Fijee-Project/utCS/doc/design_draft/src/main.tex

\documentclass[reprint]{revtex4-1}
\usepackage{graphicx}
\usepackage{amsmath}
\usepackage{epstopdf}

\begin{document}
\title{tDCS Current Driver- Design Draft}
\date{12-17-2013 Revision 1}
\author{Andrey Shmakov }

\begin{abstract}
An Engineering design draft for the tDCS current driver developed for Gazzaley lab at the University of California, San Francisco. This design draft discusses the theory of operation and the technical implementation of a computer programmable precise current source used for current injection to for rapid impedance measurements of the skull and brain to facilitate precise EEG readings
\end{abstract}
\maketitle

\input{text/goverview}

\input{text/design}

\end{document}
