Fijee-Project/utCS/doc/design_draft/src/text/design.tex

% !TEX root = ../main.tex

%TODO 1-31, everything on this page.

\section{Circuit Design}

The following sections describe the specific implementation details of the tDCS current driver. The device can split into three components. The current driver consisting of a digitally controlled voltage source and an analog voltage-to-current converter with digitally selectable gain, A multiplexer/demultiplexer module that allows coupling to a variety of different tDCS systems, and a microcontroller module that acts interfaces with all the digital devices. 

\subsection{Current Driver}
%Write a general introduction to this section
\subsubsection{Source signal generator}
% talk about the signal source generator, include a detailed connection diagram

\subsubsection{Voltage to current conversion}
%talk about the instrumentation amplifier conversion module and theory of operation, include detailed diagram

\subsubsection{Gain control}

\subsection{Multiplexer/Demultiplexer}

\subsection{Microcontroller/PC interfacing}
