Fijee-Project/utCS/doc/design_docs/BRD1ENG_SUM/text/sections/pcb/pcb.tex

\section{PCB Design}

\subsection{Layout}
