Fijee-Project/utCS/doc/design_docs/BRD1ENG_SUM/text/sections/abstract/abstract.tex

The TDCS current driver design has two component boards (see doc-
ument: TDCS Design Summary). This document describes the main
board (BRD1) of the TDCS current driver. BRD1 houses a signal gen-
erator and current driver , as well as the first bank of switches for probe
multiplexing.
