Fijee-Project/utCS/doc/design_docs/BRD1ENG_SUM/text/sections/appendices/appendixA.tex

\section{Circuit Diagrams}

\section{PCB Images}

\section{Bill Of Materials}
