Fijee-Project/utCS/doc/design_docs/BRD1ENG_SUM/text/sections/overview/overview.tex

\section*{Overview}
This document provides a comprehensive engineering summary of the TDCS device mainboard (Engineering designation BRD1). This document follows the following general outline: Schematic design, component selection, PC board layout, manufacturing, and assembly. The appendices contain full page technical drawings of the schematic, pcb layout, and bill of materials, including pcb component dimensions and pcb footprint specifications.
