Fijee-Project/utCS/doc/notes/tdcs_keepnote_notebook/main board/pcb/connectors/screenshot from 2014-03-11 171706.png

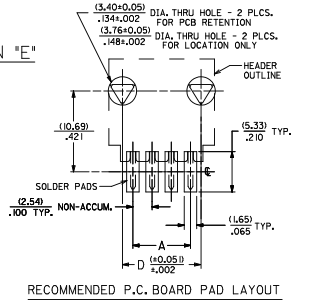
doc/notes/tdcs_keepnote_notebook/main board/pcb/connectors/screenshot from 2014-03-11 171706.png
