Fijee-Project/utCS/doc/notes/tdcs_keepnote_notebook/main board/pcb/connectors/screenshot from 2014-03-14 152904.png

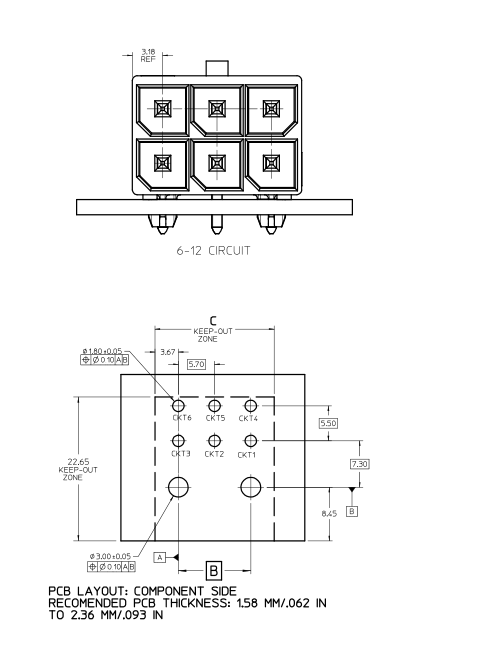
doc/notes/tdcs_keepnote_notebook/main board/pcb/connectors/screenshot from 2014-03-14 152904.png
