Fijee-Project/utCS/doc/notes/tdcs_keepnote_notebook/main board/pcb/connectors/screenshot from 2014-03-15 175426.png

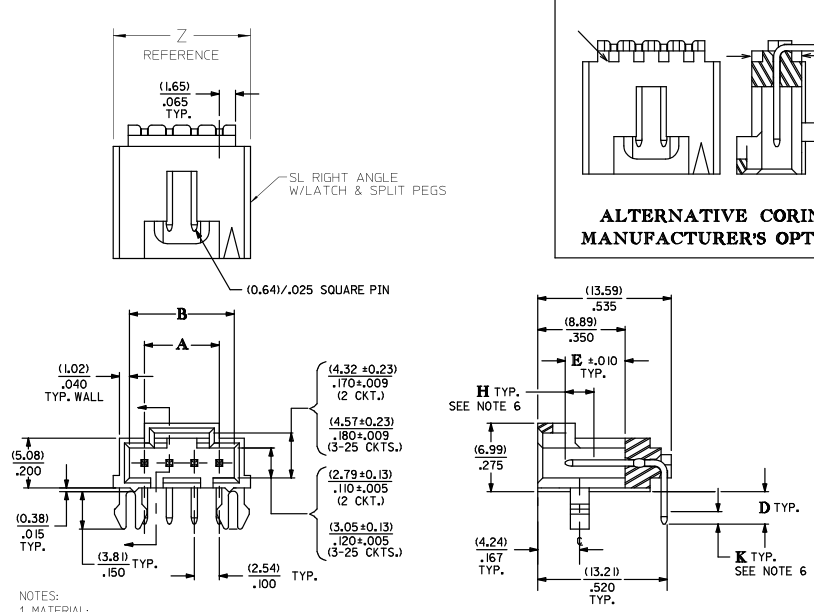
doc/notes/tdcs_keepnote_notebook/main board/pcb/connectors/screenshot from 2014-03-15 175426.png
