Fijee-Project/utCS/doc/notes/tdcs_keepnote_notebook/main board/pcb/dds stage/screenshot from 2014-03-10 201614.png

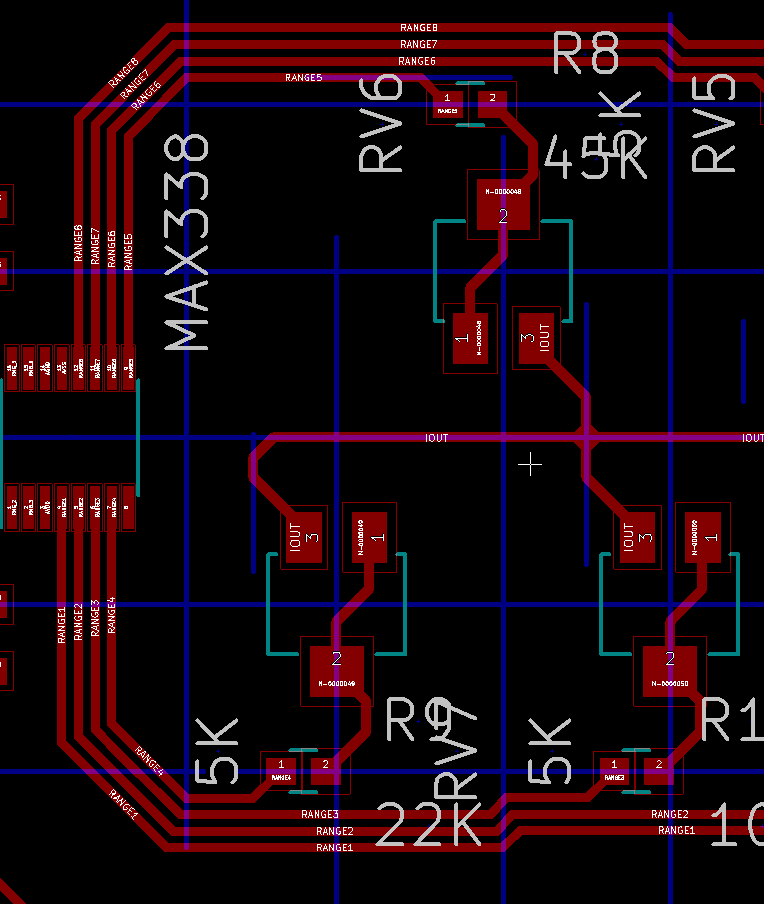
doc/notes/tdcs_keepnote_notebook/main board/pcb/dds stage/screenshot from 2014-03-10 201614.png
