Fijee-Project/utCS/doc/notes/tdcs_keepnote_notebook/main board/schematic/dds stage/screenshot from 2014-03-05 201427.png

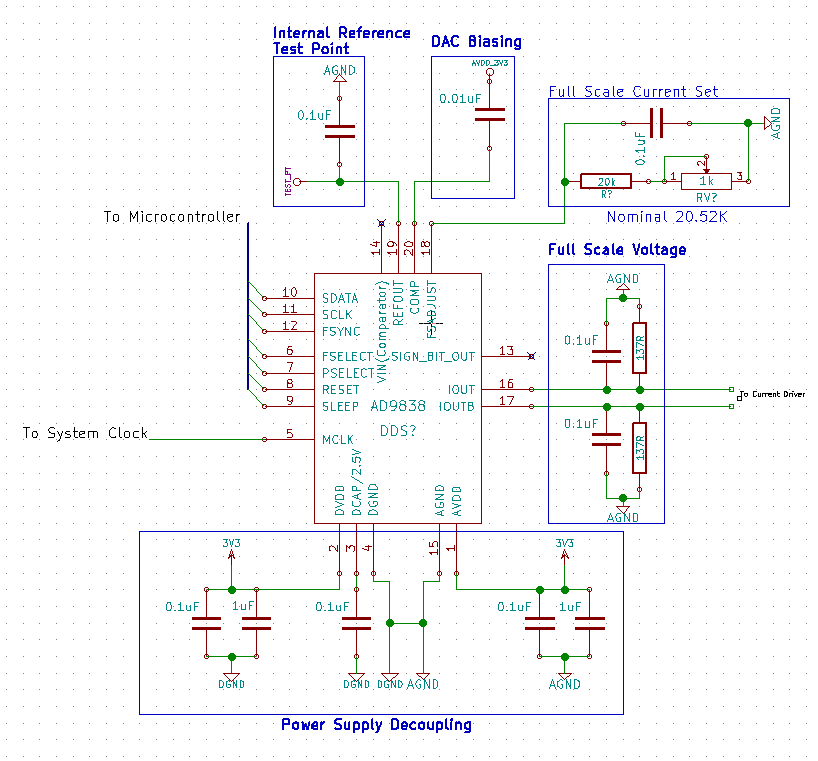
doc/notes/tdcs_keepnote_notebook/main board/schematic/dds stage/screenshot from 2014-03-05 201427.png
