Fijee-Project/utCS/doc/notes/tdcs_keepnote_notebook/mux daughterboard/pcb/connectors/screenshot from 2014-03-14 194821.png

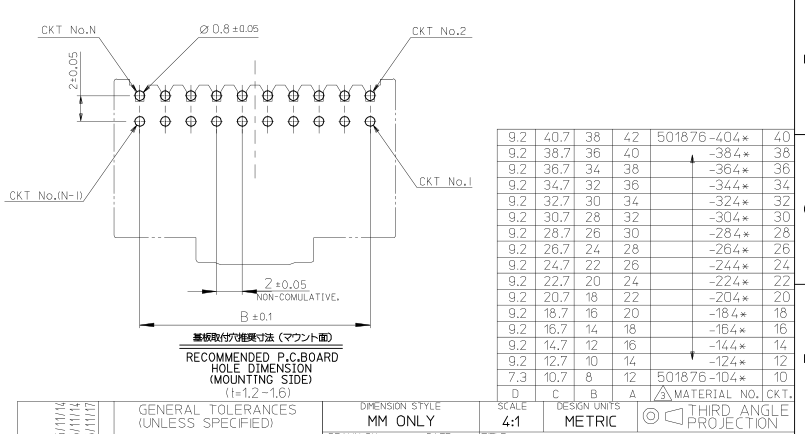
doc/notes/tdcs_keepnote_notebook/mux daughterboard/pcb/connectors/screenshot from 2014-03-14 194821.png
