Fijee-Project/utCS/doc/notes/tdcs_keepnote_notebook/mux daughterboard/pcb/physical layout/brd.png

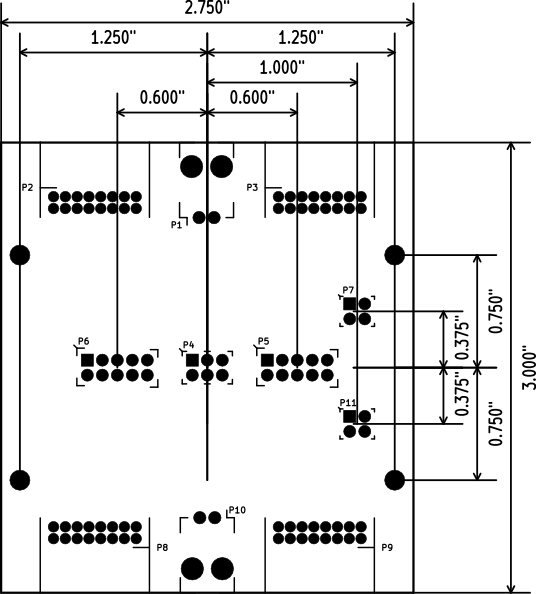
doc/notes/tdcs_keepnote_notebook/mux daughterboard/pcb/physical layout/brd.png
