Fijee-Project/utCS/doc/notes/tdcs_keepnote_notebook/package notes/ad5292/screenshot from 2014-02-27 185433.png

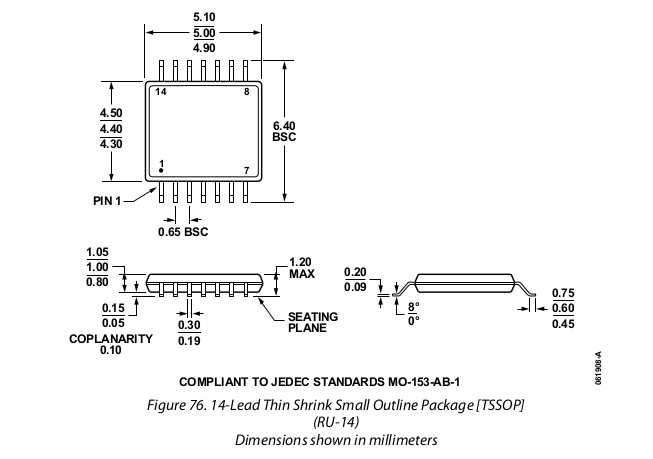
doc/notes/tdcs_keepnote_notebook/package notes/ad5292/screenshot from 2014-02-27 185433.png
