Fijee-Project/utCS/doc/notes/tdcs_keepnote_notebook/package notes/ad8221/screenshot from 2014-02-28 171705.png

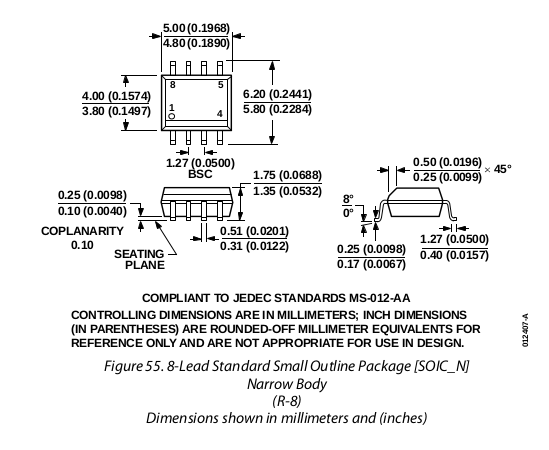
doc/notes/tdcs_keepnote_notebook/package notes/ad8221/screenshot from 2014-02-28 171705.png
