Fijee-Project/utCS/doc/notes/tdcs_keepnote_notebook/package notes/ad9838/screenshot from 2014-02-27 181038.png

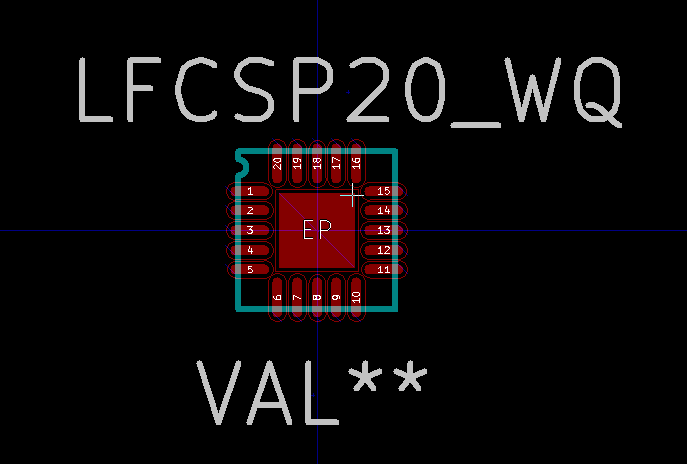
doc/notes/tdcs_keepnote_notebook/package notes/ad9838/screenshot from 2014-02-27 181038.png
