Fijee-Project/utCS/doc/notes/tdcs_keepnote_notebook/package notes/adg732/screenshot from 2014-03-14 213722.png

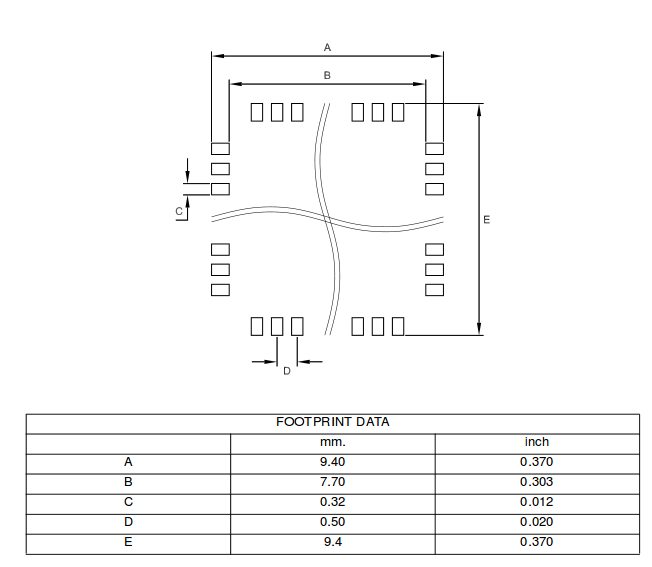
doc/notes/tdcs_keepnote_notebook/package notes/adg732/screenshot from 2014-03-14 213722.png
