Fijee-Project/utCS/doc/notes/tdcs_keepnote_notebook/package notes/chip resistors and chip capactiros/screenshot from 2014-02-28 184616.png

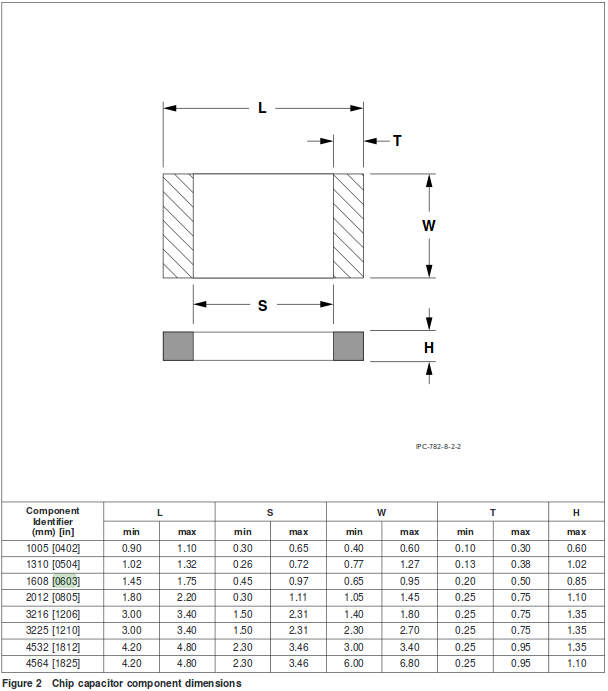
doc/notes/tdcs_keepnote_notebook/package notes/chip resistors and chip capactiros/screenshot from 2014-02-28 184616.png
