Fijee-Project/utCS/doc/notes/tdcs_keepnote_notebook/package notes/ecx-53b crystal/screenshot from 2014-02-28 180053.png

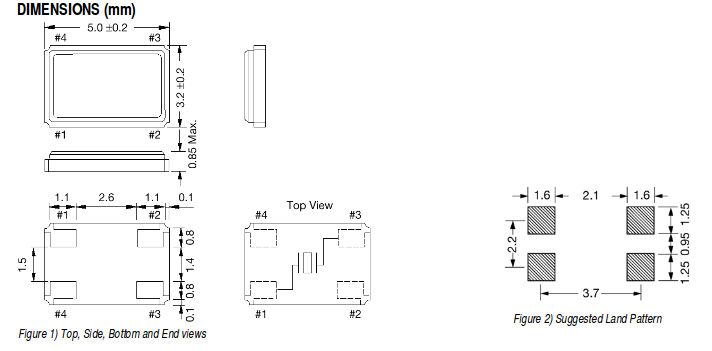
doc/notes/tdcs_keepnote_notebook/package notes/ecx-53b crystal/screenshot from 2014-02-28 180053.png
