Fijee-Project/utCS/doc/notes/tdcs_keepnote_notebook/package notes/max338-339/screenshot from 2014-02-28 155805.png

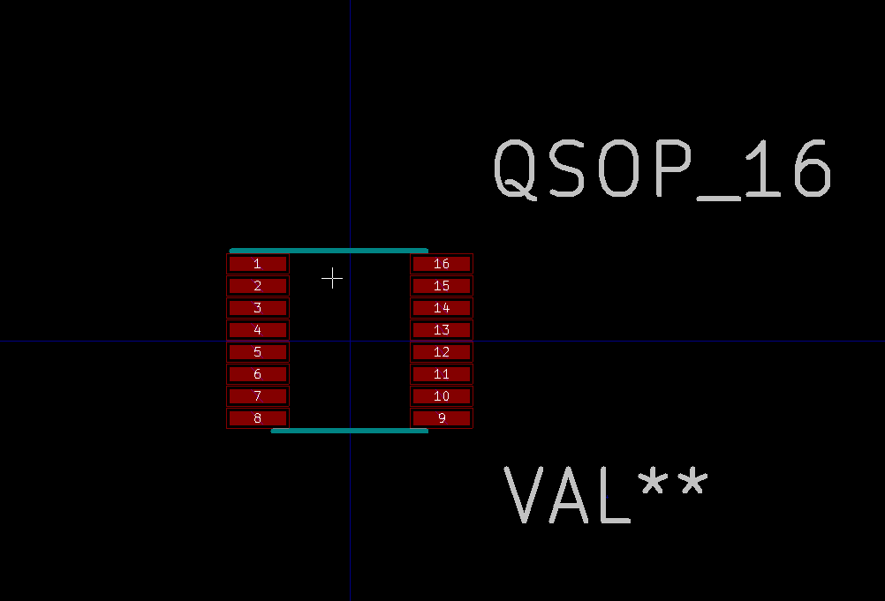
doc/notes/tdcs_keepnote_notebook/package notes/max338-339/screenshot from 2014-02-28 155805.png
