Fijee-Project/utCS/doc/notes/tdcs_keepnote_notebook/package notes/max3002/screenshot from 2014-02-28 190120.png

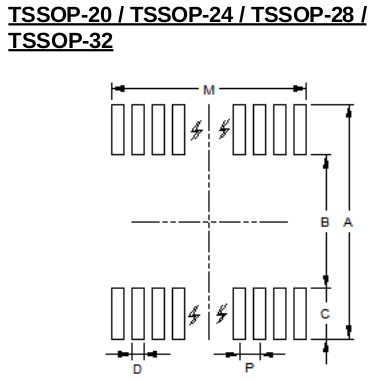
doc/notes/tdcs_keepnote_notebook/package notes/max3002/screenshot from 2014-02-28 190120.png
