Fijee-Project/utCS/doc/notes/tdcs_keepnote_notebook/package notes/si5351a/screenshot from 2014-02-28 163953.png

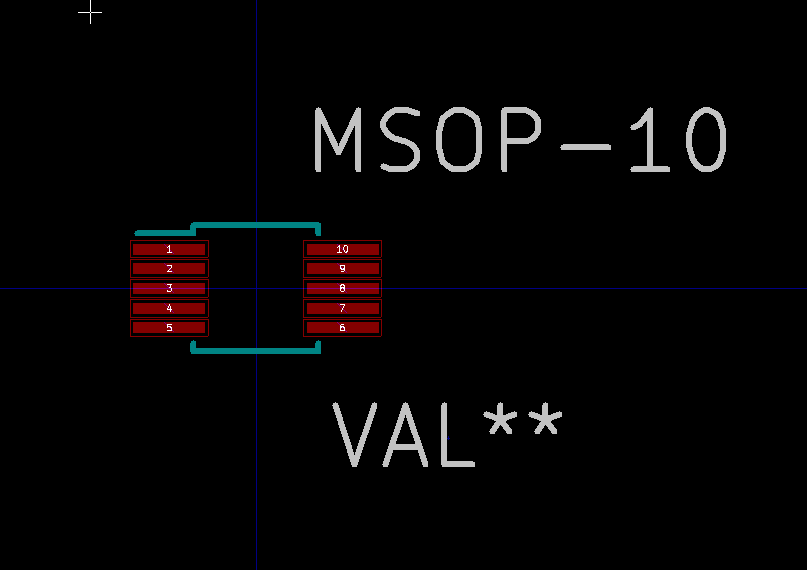
doc/notes/tdcs_keepnote_notebook/package notes/si5351a/screenshot from 2014-02-28 163953.png
