Fijee-Project/utCS/doc/notes/tdcs_keepnote_notebook/package notes/smd-trimpots (bourne 3224)/screenshot from 2014-02-28 174825.png

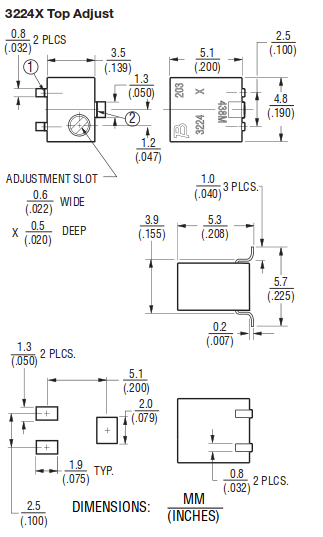
doc/notes/tdcs_keepnote_notebook/package notes/smd-trimpots (bourne 3224)/screenshot from 2014-02-28 174825.png
