Fijee-Project/utCS/doc/notes/tdcs_keepnote_notebook/mux daughterboard/schematic/components/screenshot from 2014-03-15 164229.png

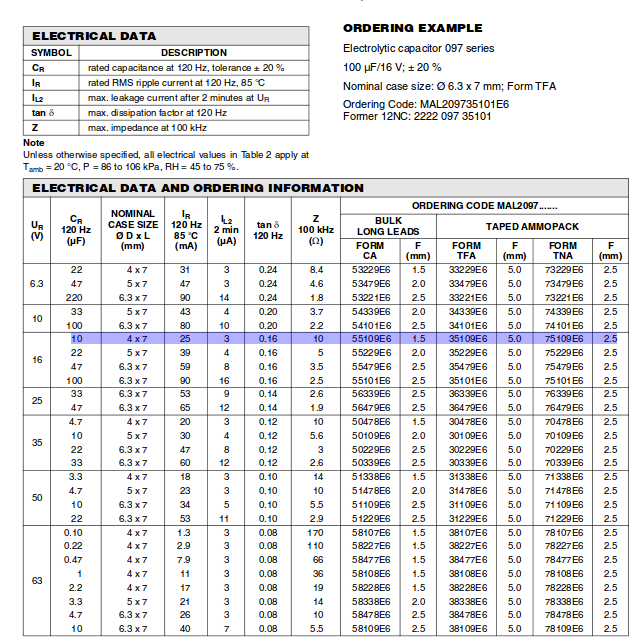
doc/notes/tdcs_keepnote_notebook/mux daughterboard/schematic/components/screenshot from 2014-03-15 164229.png
