Fijee-Project/utCS/doc/notes/tdcs_keepnote_notebook/current todo/page.html

Current TODO list

DaughterBoard:
production:
Verify all ic footprints
Create gerber and drill file
check gerber and drill file
send off to seeedstudio

design:
migrate all component symbols, modules, and footprints to custom libraries for each project.

MainBoard:

design:
Verify/create all module footprints (Done for mainboard 2/28)
Rough Design of module layoutv (Doneish)
Choose board connectors for interfacing (make footprints) (Done for mainboard 3/14)
Desing/route/gerber (Partial as of 3/14)
FIX SILKSCREEN FOR COMPONENTS, too messy.
