Fijee-Project/utCS/doc/design_draft/src/images/generaldiagram/current-eps-converted-to.pdf

# Current ReturnParallel

# Microcontroller

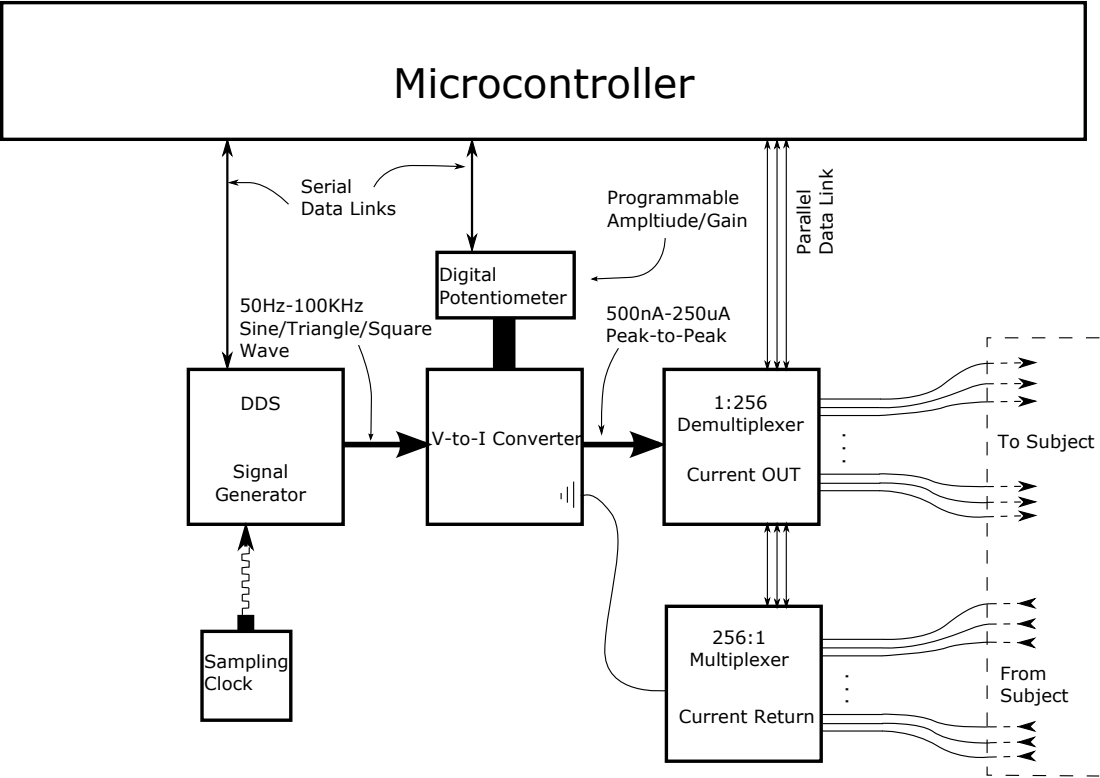
[picture p45: page 1]
Digital Potentiometer; Programmable Ampltiude/Gain; V-to-I Converter; DDS; Signal Generator; Serial Data Links; Sampling Clock; 1:256 Demultiplexer; Current OUT; 256:1 Multiplexer; Data Link; To Subject; From Subject; 50Hz-100KHz Sine/Triangle/Square Wave

Peak-to-Peak
