Fijee-Project/utCS/hw/main_board/kicad_project/tDCS_driver.pdf

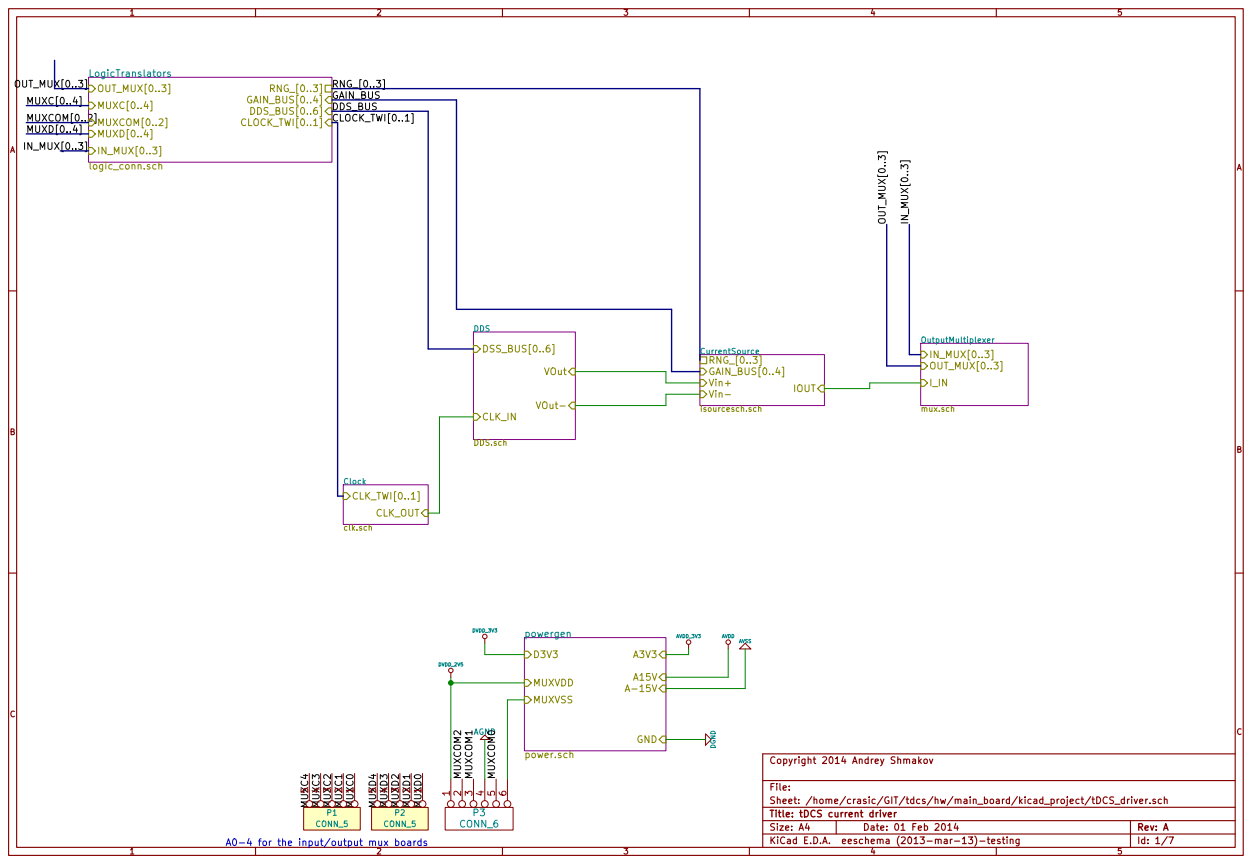
[picture p46: page 1]

isourcesch.sch Vin+ Vin- RNG_[0..3]
GAIN_BUS[0..4]

KiCad E.D.A. eeschema (2013-mar-13)-testing Date: 01 Feb 2014 DGND

Sheet: /home/crasic/GIT/tdcs/hw/main_board/kicad_project/tDCS_driver.sch File: Title: tDCS current driver

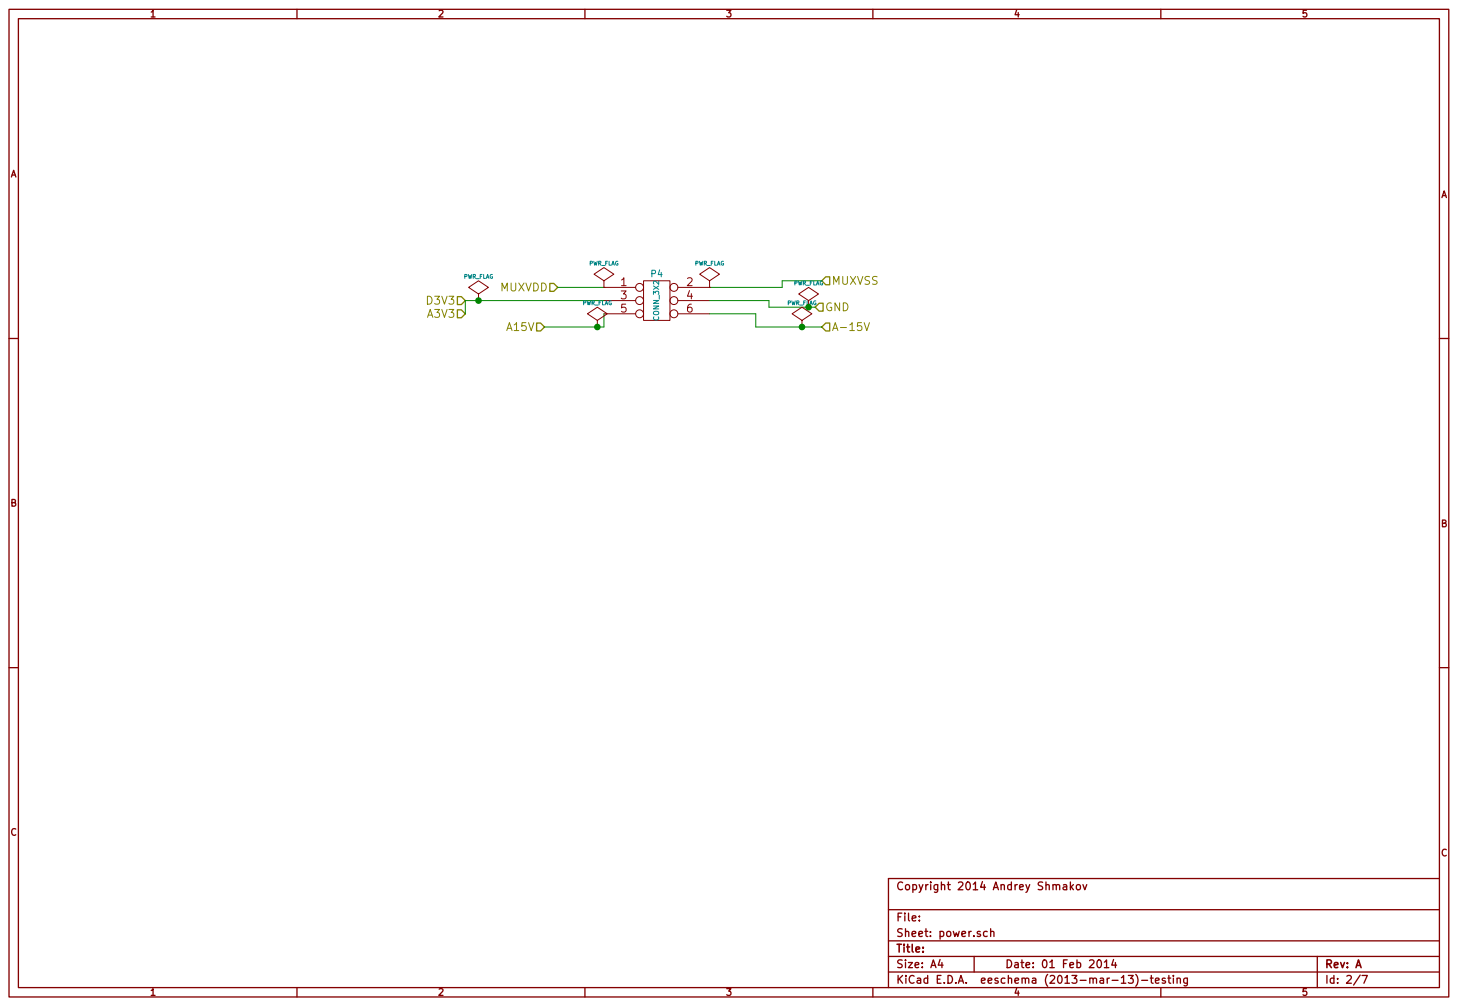
[picture p47: page 2]

Sheet: power.sch File: Title:

KiCad E.D.A. eeschema (2013-mar-13)-testing Date: 01 Feb 2014

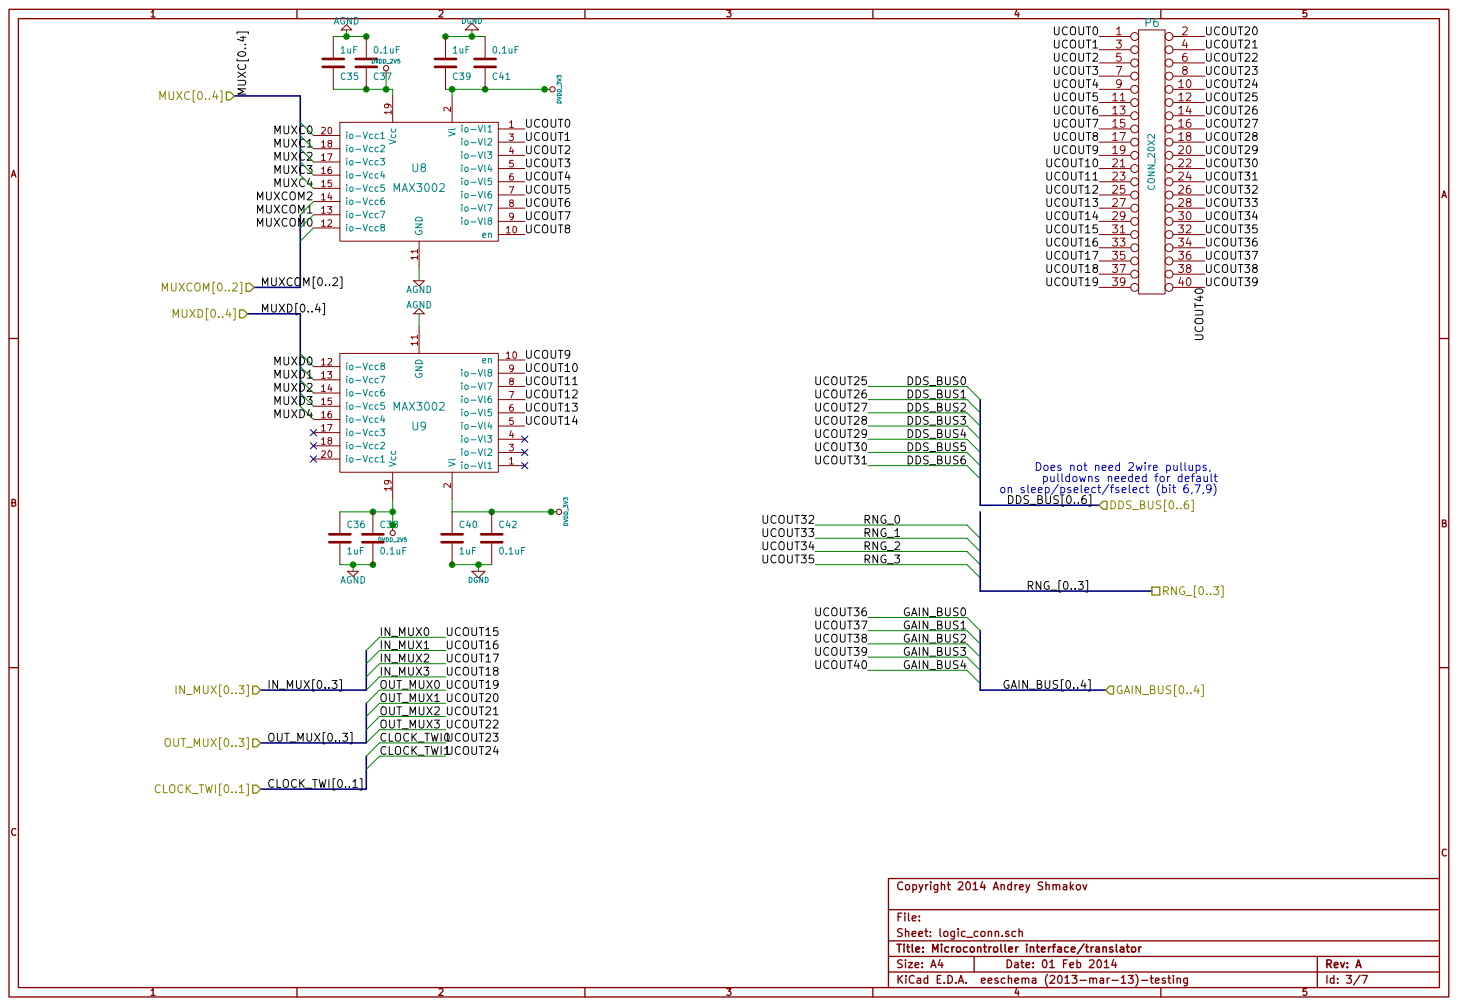
[picture p48: page 3]

Does not need 2wire pullups,
pulldowns needed for default
on sleep/pselect/fselect (bit 6,7,9)
DDS_BUS[0..6]

Sheet: logic_conn.sch File: Title: Microcontroller interface/translator

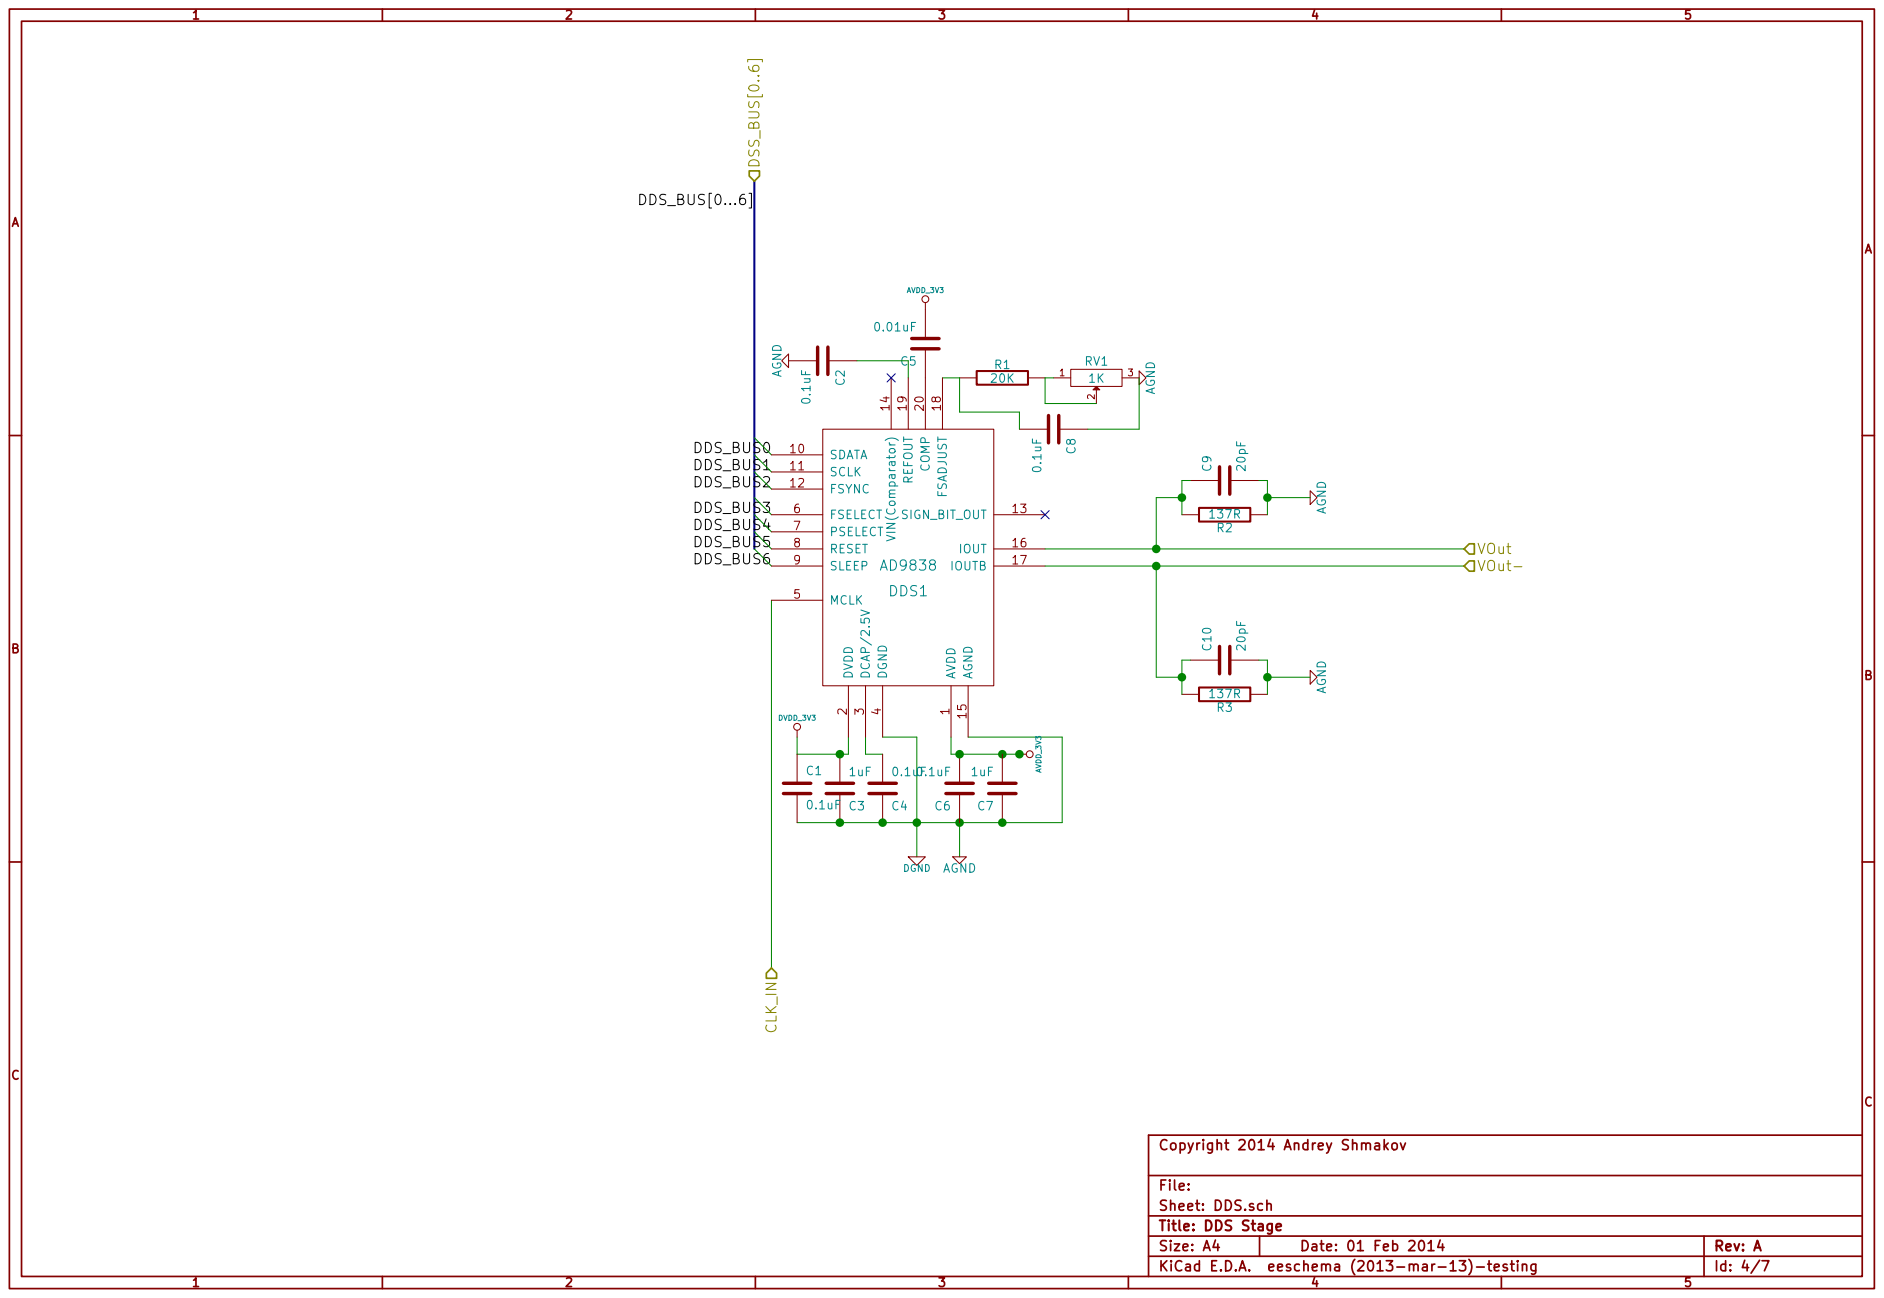
[picture p49: page 4]

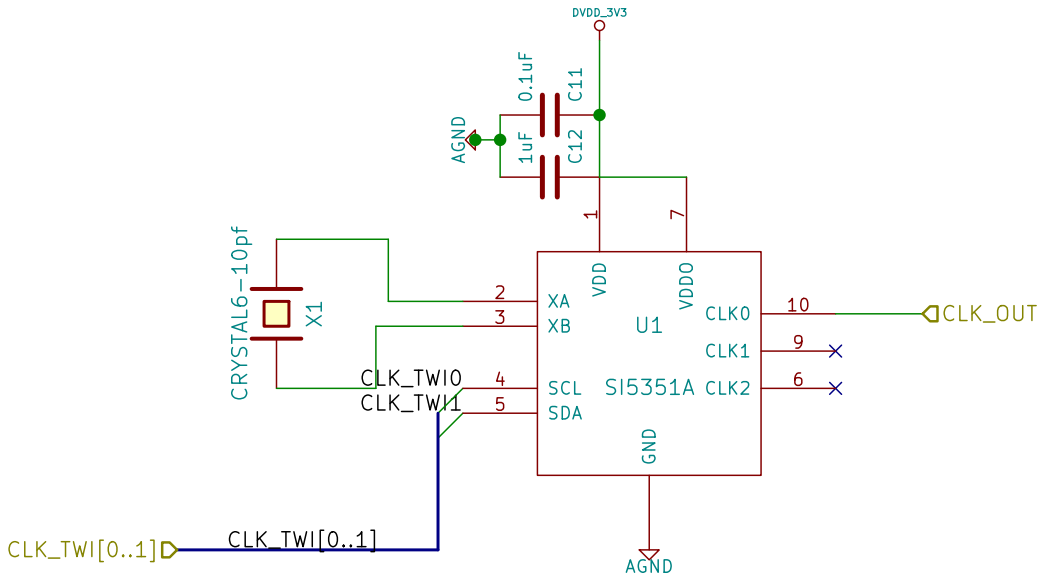
[picture p50: page 5]

1 XA 2 XB 3 SCL 4 SDA 5 CLK2 6 VDDO

C Copyright 2014 Andrey Shmakov Sheet: clk.sch File: Title: Clock

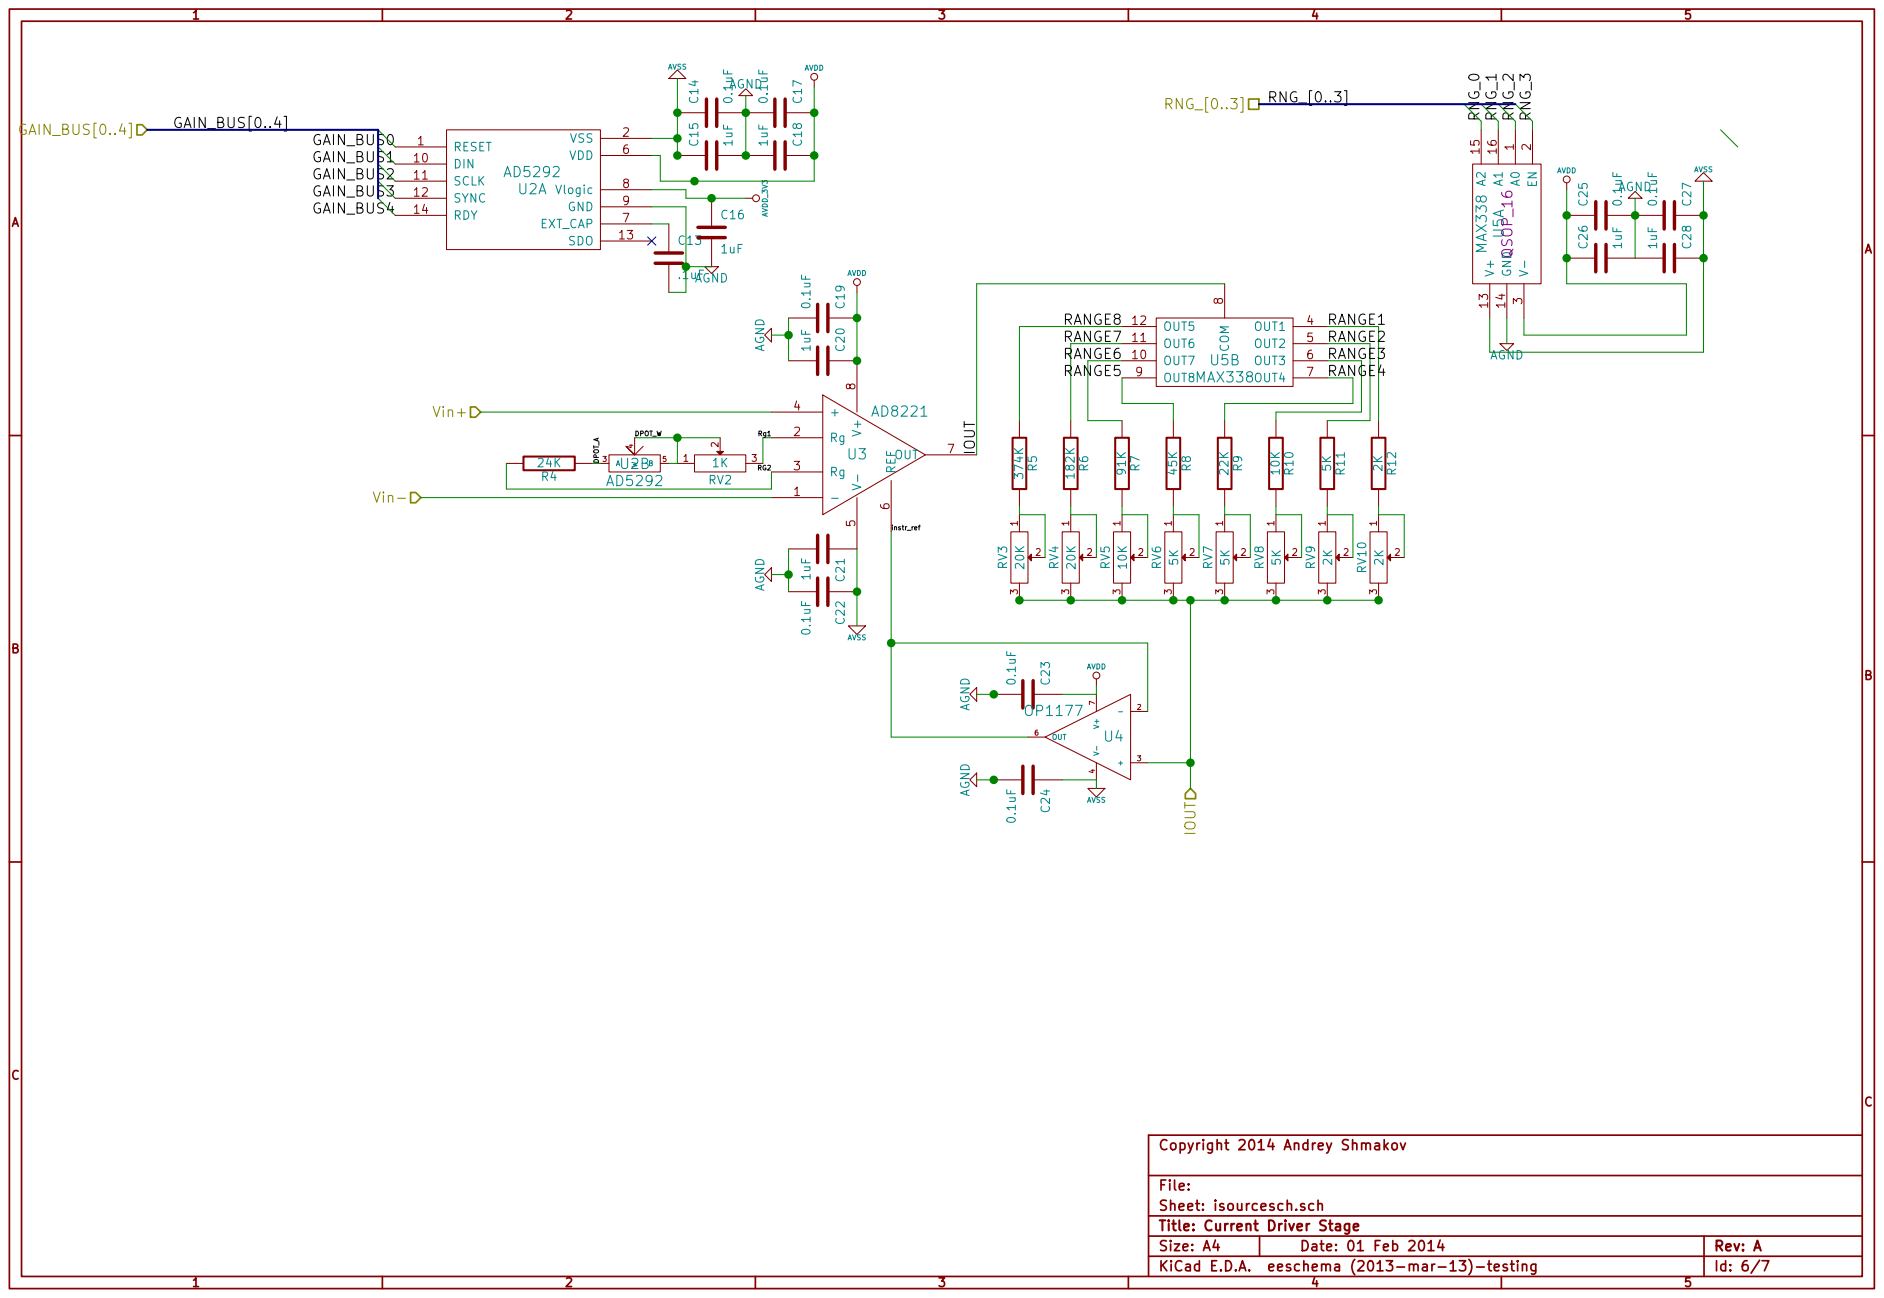
[picture p51: page 6]

C Copyright 2014 Andrey Shmakov Sheet: isourcesch.sch File: Title: Current Driver Stage

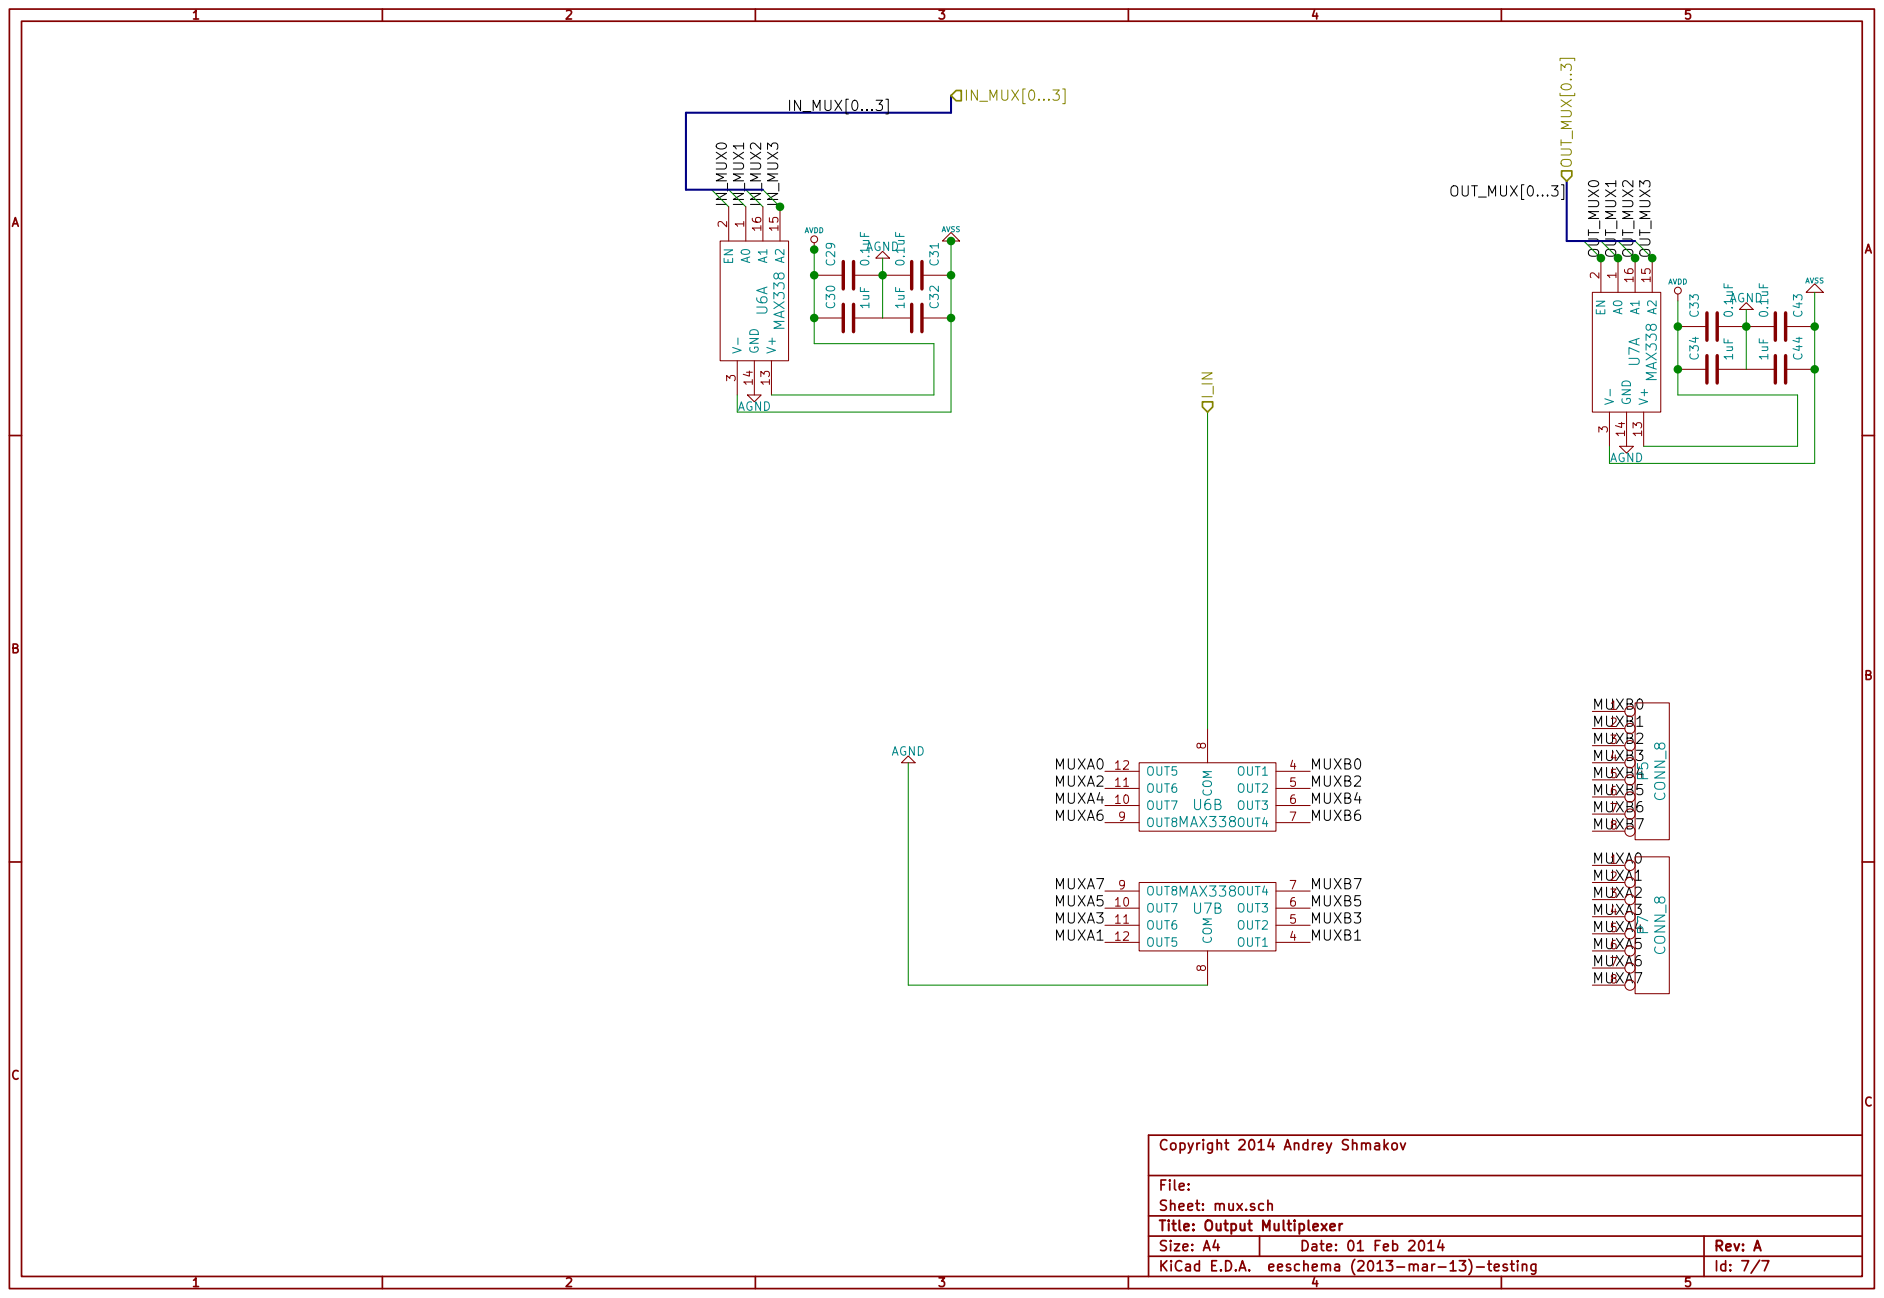
[picture p52: page 7]

KiCad E.D.A. eeschema (2013-mar-13)-testing Date: 01 Feb 2014 MUXB7 MUXB6 MUXB5 MUXB4 MUXB3 MUXB2 MUXB1 MUXB0 MUXA7 MUXA6 MUXA5 MUXA4 MUXA3 MUXA2 MUXA1 MUXA0
