Fijee-Project/utCS/doc/design_draft/src/images/brdlayout/board_layout-full.pdf

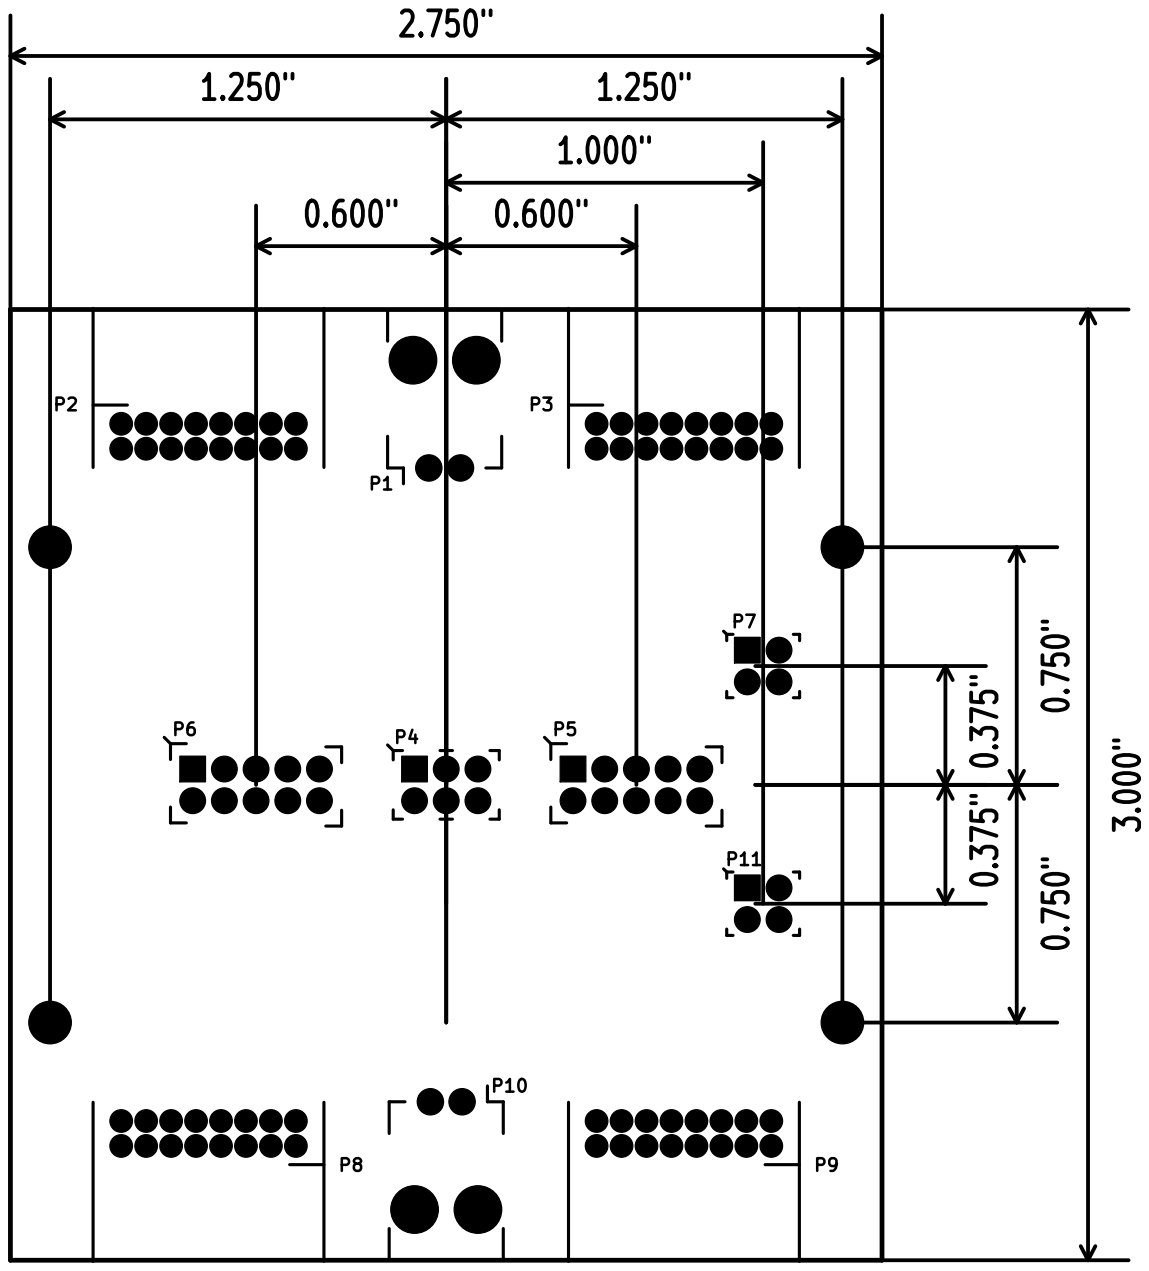
[picture p53: page 1]
