Fijee-Project/utCS/doc/design_docs/BRD1ENG_SUM/assets/images/Clock/clocksch.pdf

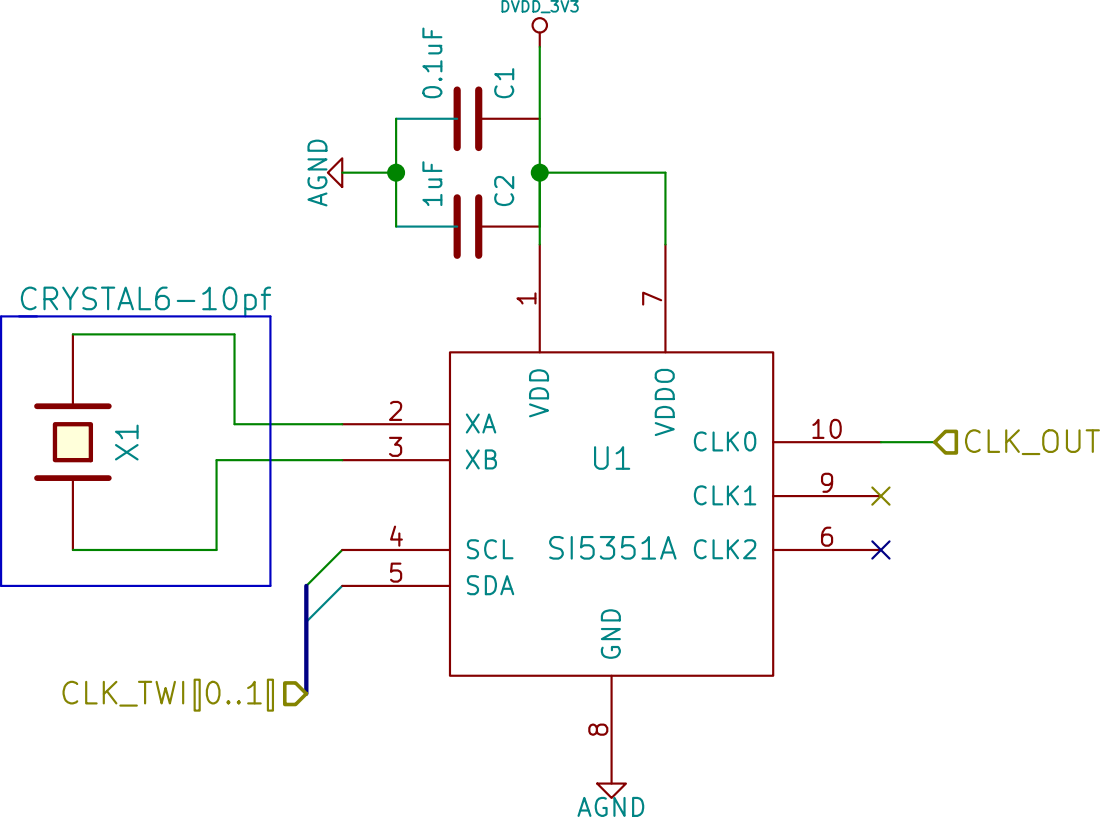
[picture p54: page 1]
