Fijee-Project/utCS/doc/design_docs/BRD1ENG_SUM/assets/images/Current_Stage/currentstage.pdf

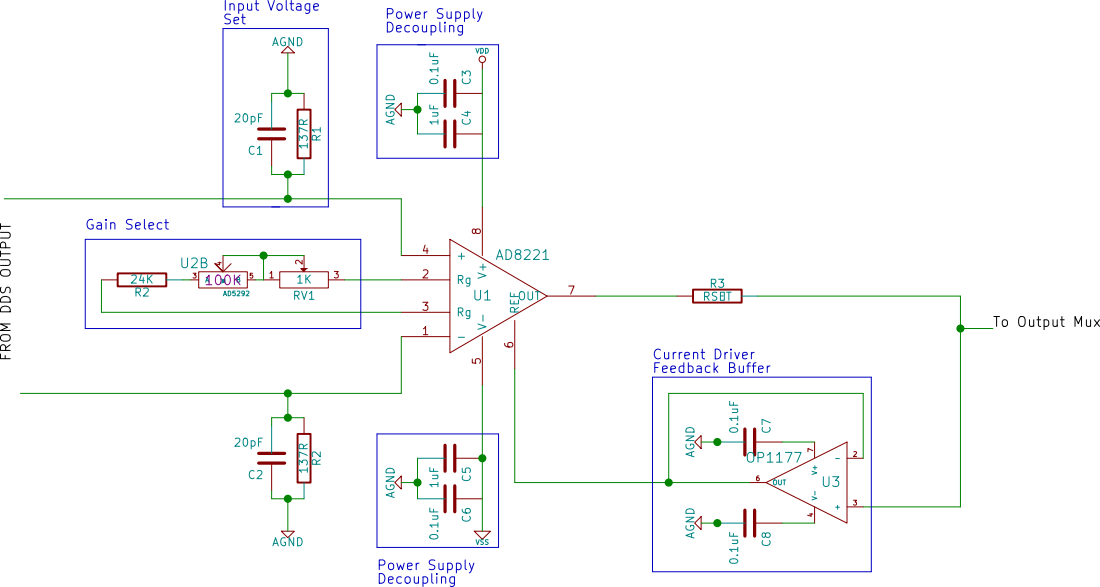
[picture p55: page 1]
