Fijee-Project/utCS/doc/design_docs/BRD1ENG_SUM/assets/images/Range_Select/range_select.pdf

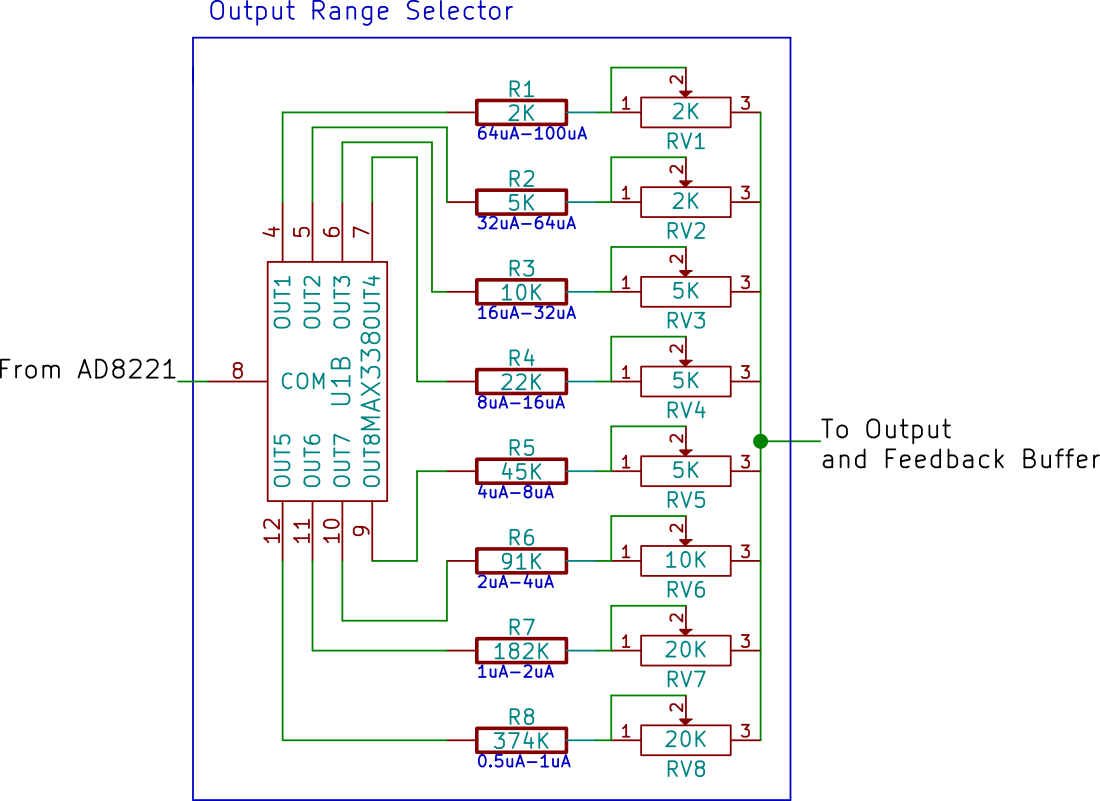
[picture p56: page 1]
