Fijee-Project/utCS/doc/design_docs/BRD1ENG_SUM/assets/images/DDS_Stage/DDS_stage.pdf

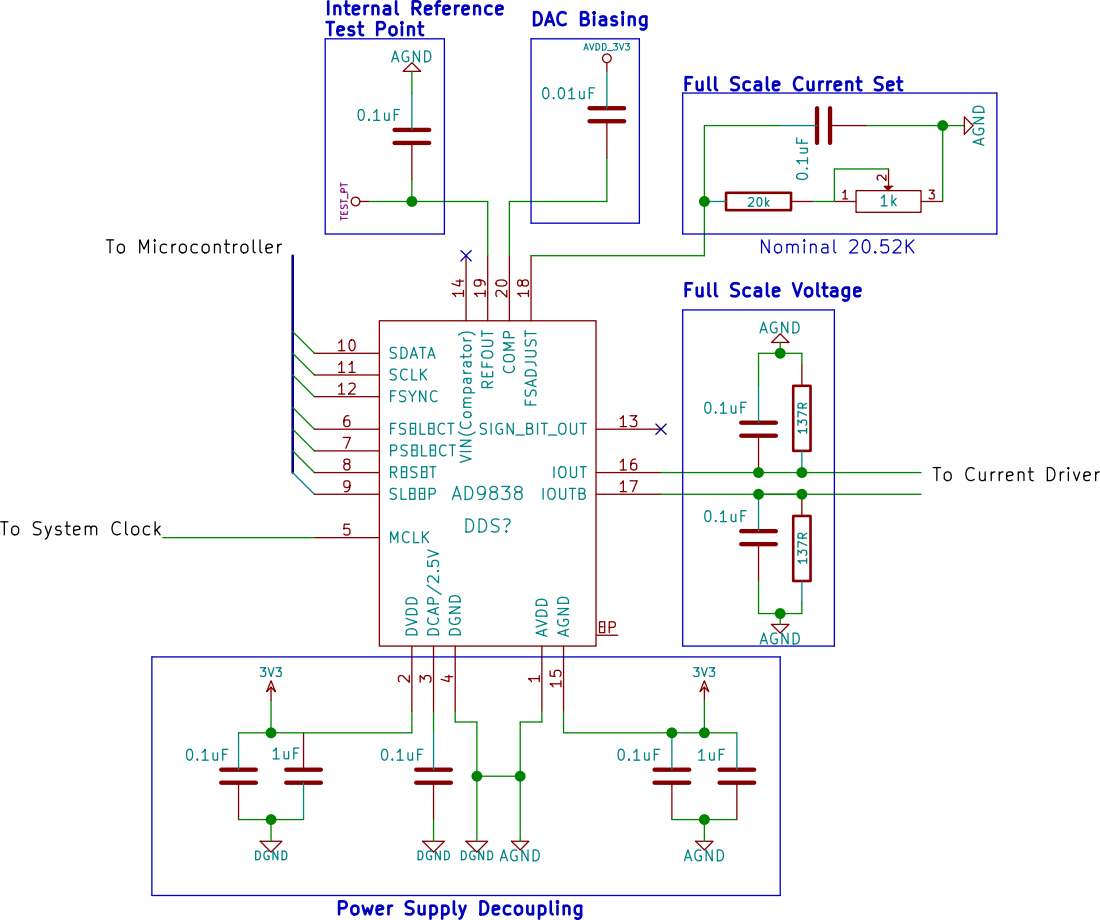
[picture p57: page 1]
