Fijee-Project/utCS/doc/design_docs/BRD1ENG_SUM/assets/images/DDS_Stage/DDS_stage_big.pdf

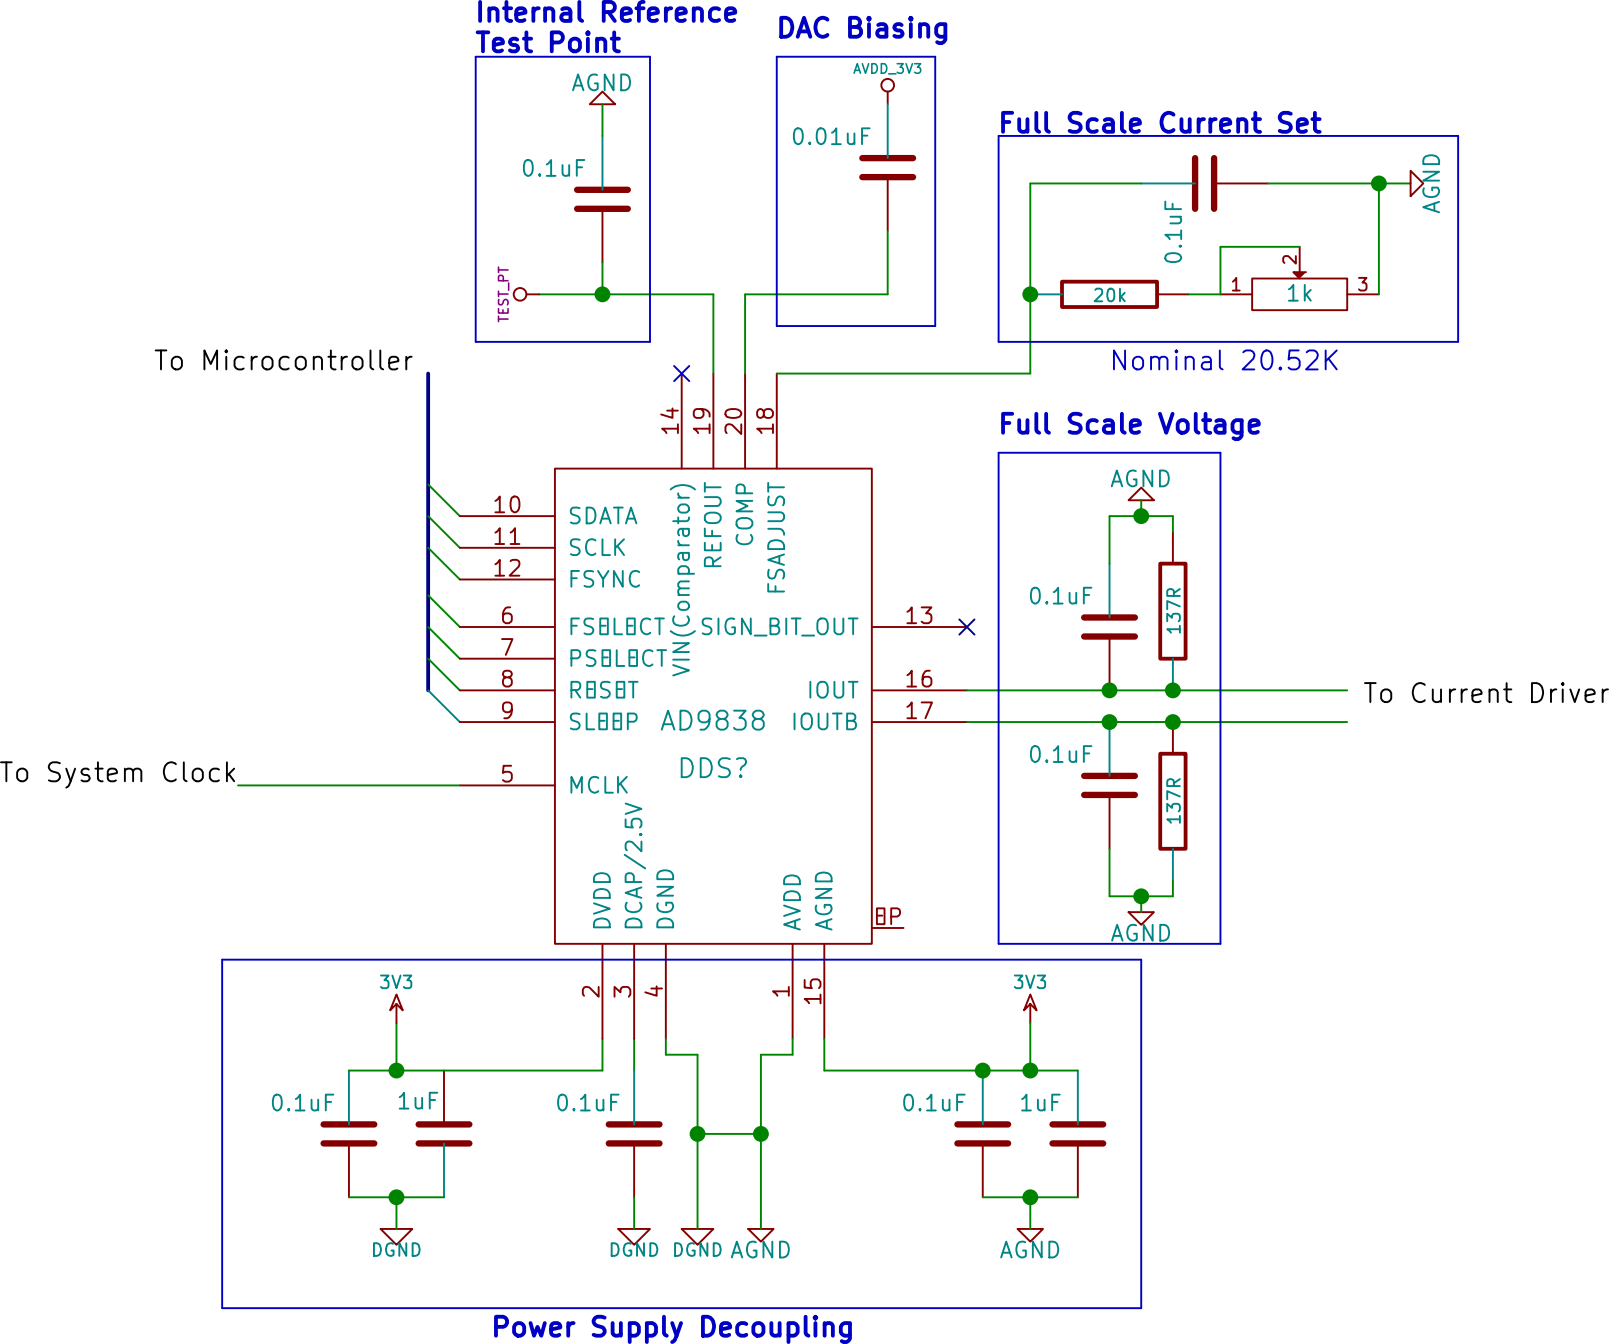
[picture p58: page 1]
