Fijee-Project/utCS/doc/design_draft/src/images/brd1/front/brd1-front.pdf

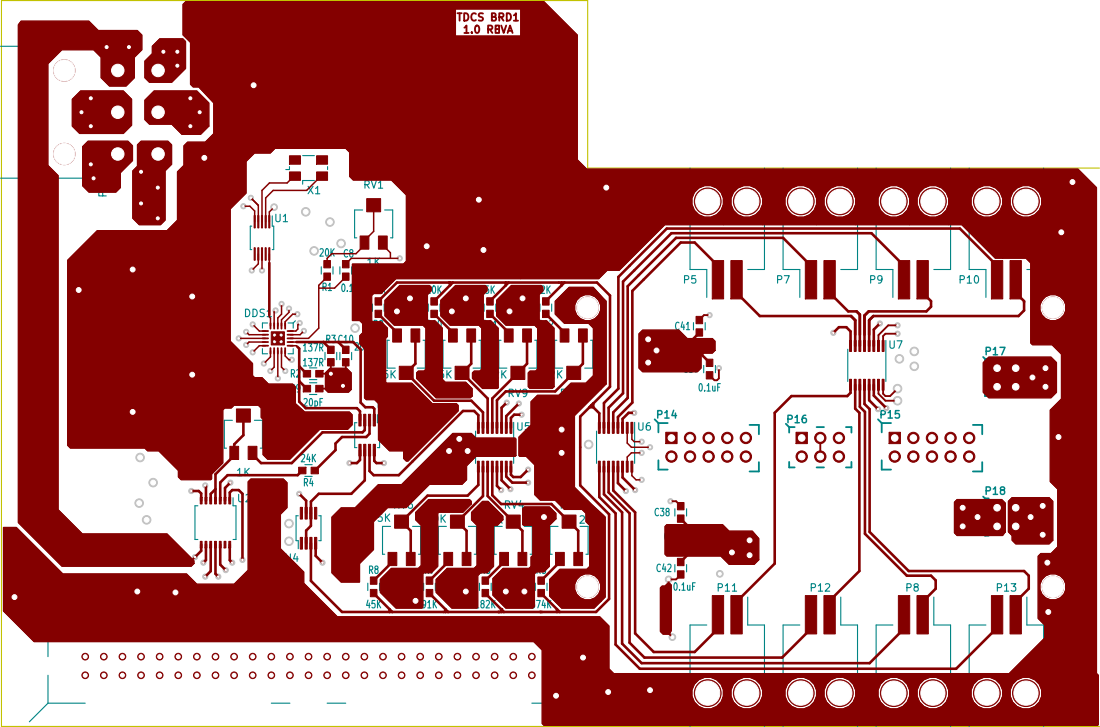
[picture p59: page 1]
