Fijee-Project/utCS/doc/design_draft/src/images/brd1/front/brd2-front.pdf

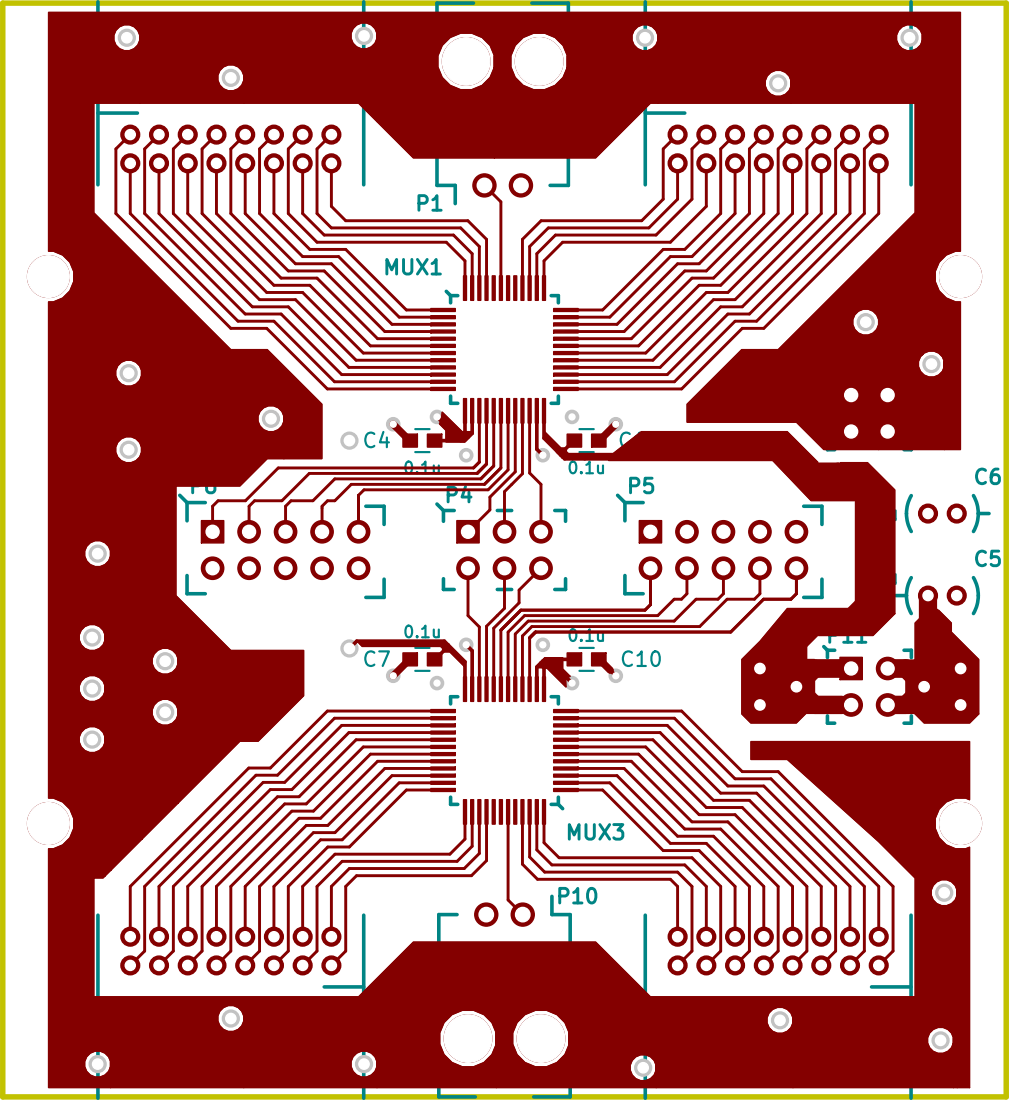
[picture p60: page 1]
