Fijee-Project/utCS/hw/demux_daughterboard/kicad_proj/demux-panel.kicad_pcb

## KiCad design hw/demux_daughterboard/kicad_proj/demux-panel.kicad_pcb (2014-04-01)

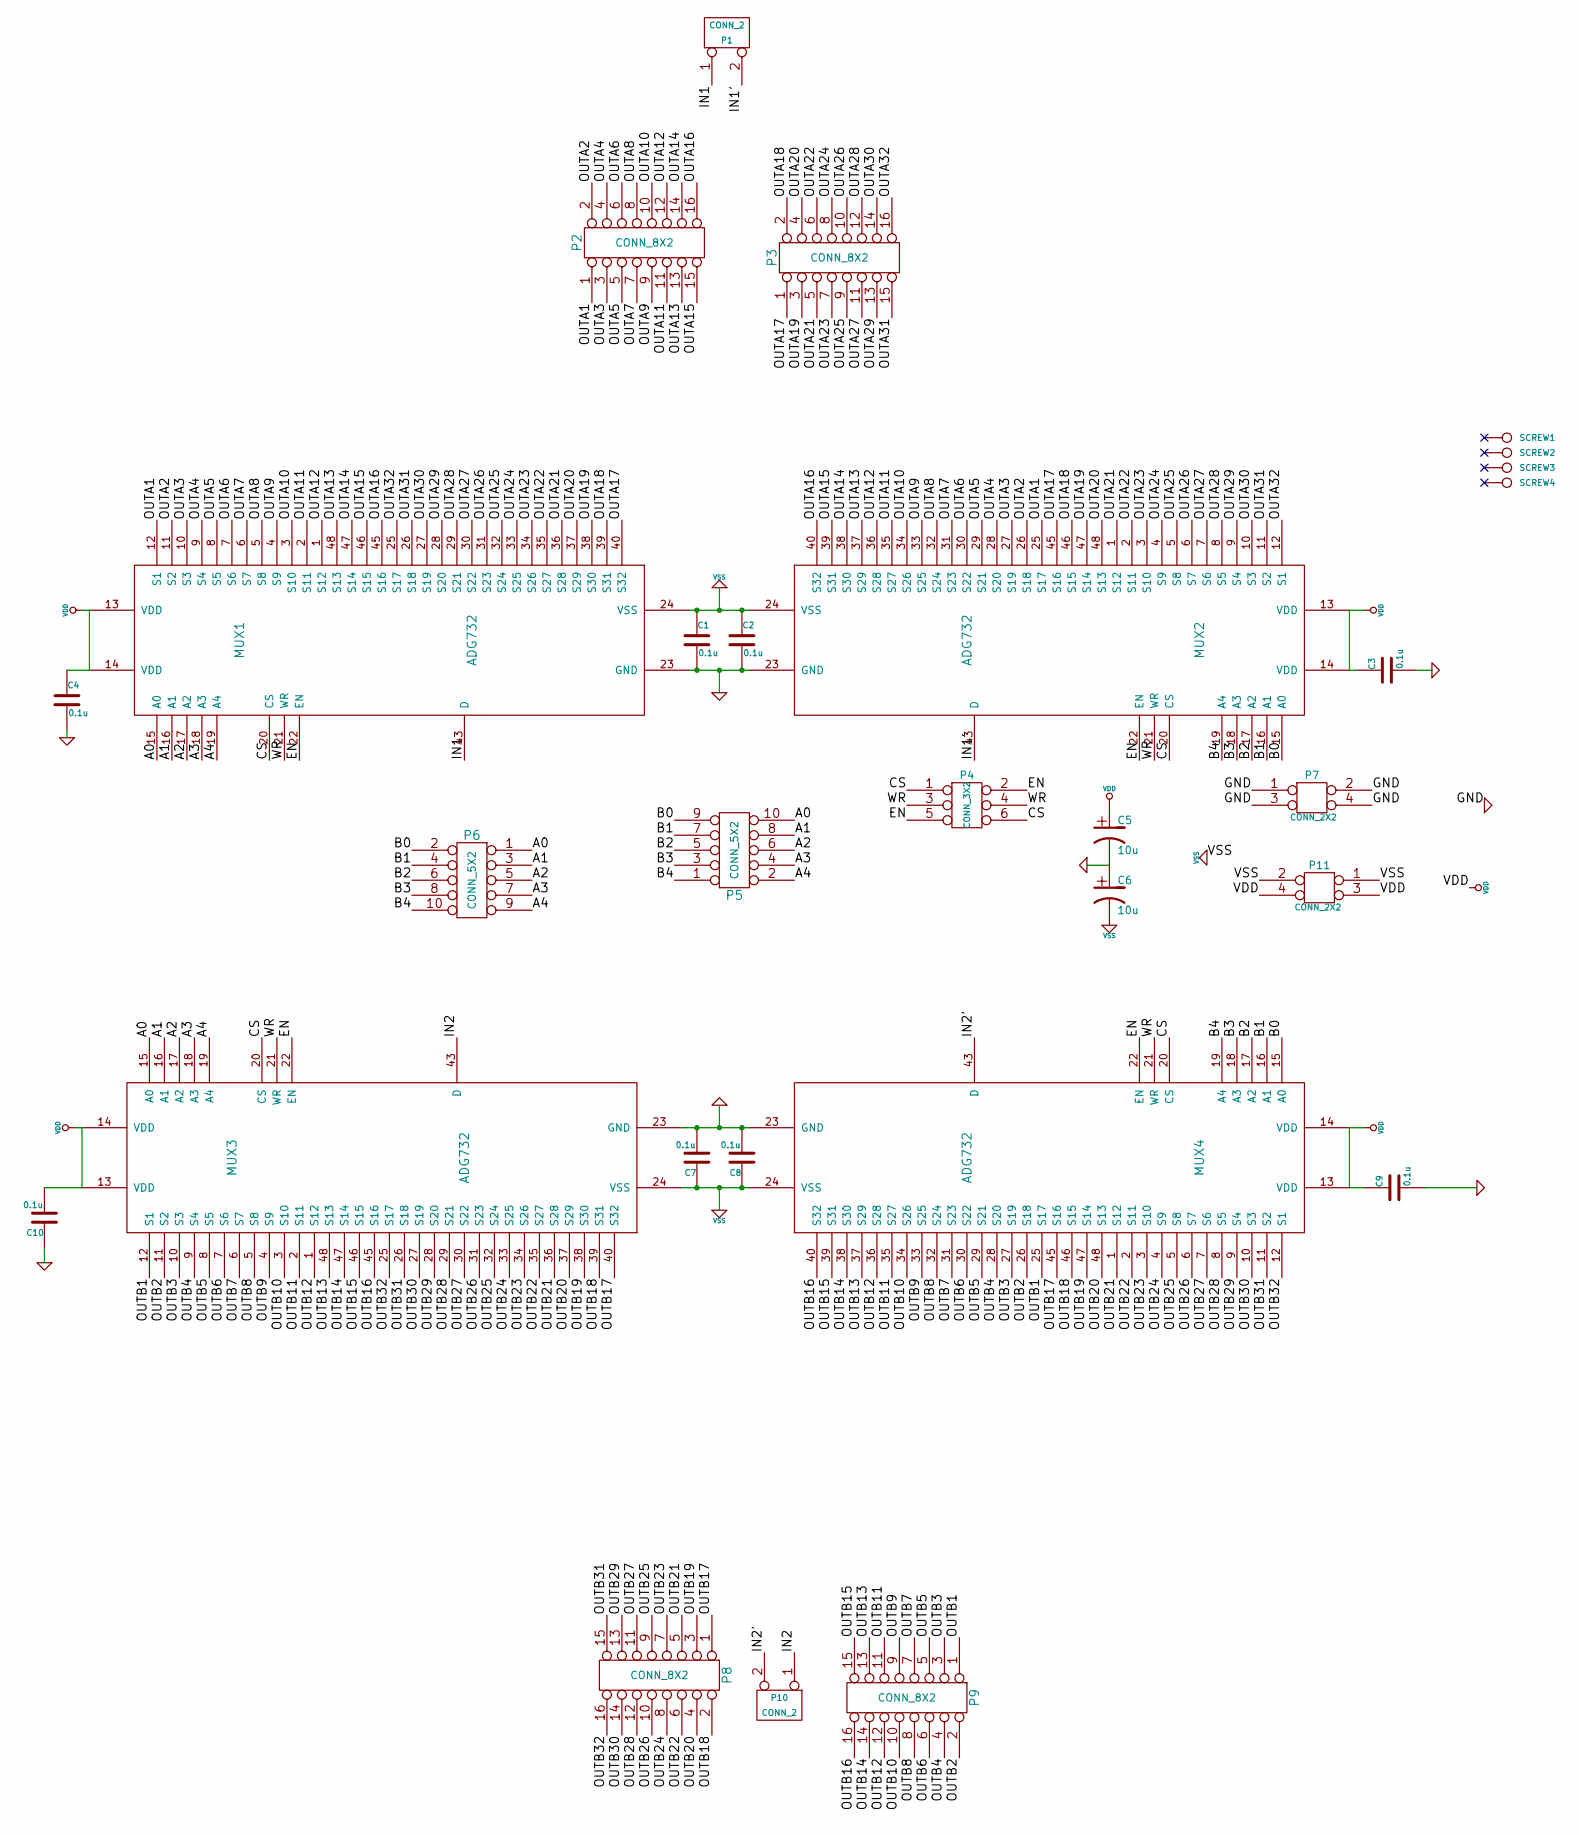
[picture p63: schematic demux-panel.sch, noname.sch]

Parts:
C1, C2, C3, C4, C7, C8, C9, C10: 0.1u
C5, C6: 10u
MUX1, MUX2, MUX3, MUX4: ADG732
P1, P10: CONN_2
P2, P3, P8, P9: CONN_8X2
P4: CONN_3X2
P5, P6: CONN_5X2
P7, P11: CONN_2X2
SCREW1, SCREW2, SCREW3, SCREW4: CONN_1

Connections:
/A0: MUX1.15 (A0), MUX3.15 (A0), P5.10, P6.1
/A1: MUX1.16 (A1), MUX3.16 (A1), P5.8, P6.3
/A2: MUX1.17 (A2), MUX3.17 (A2), P5.6, P6.5
/A3: MUX1.18 (A3), MUX3.18 (A3), P5.4, P6.7
/A4: MUX1.19 (A4), MUX3.19 (A4), P5.2, P6.9
/B0: MUX2.15 (A0), MUX4.15 (A0), P5.9, P6.2
/B1: MUX2.16 (A1), MUX4.16 (A1), P5.7, P6.4
/B2: MUX2.17 (A2), MUX4.17 (A2), P5.5, P6.6
/B3: MUX2.18 (A3), MUX4.18 (A3), P5.3, P6.8
/B4: MUX2.19 (A4), MUX4.19 (A4), P5.1, P6.10
/CS: MUX1.20 (CS), MUX2.20 (CS), MUX3.20 (CS), MUX4.20 (CS), P4.1, P4.6
/EN: MUX1.22 (EN), MUX2.22 (EN), MUX3.22 (EN), MUX4.22 (EN), P4.2, P4.5
/IN1: MUX1.43 (D), P1.1
/IN1': MUX2.43 (D), P1.2 (PM)
/IN2: MUX3.43 (D), P10.1
/IN2': MUX4.43 (D), P10.2 (PM)
/OUTA1: MUX1.12 (S1), MUX2.25 (S17), P2.1
/OUTA2: MUX1.11 (S2), MUX2.26 (S18), P2.2
/OUTA3: MUX1.10 (S3), MUX2.27 (S19), P2.3
/OUTA4: MUX1.9 (S4), MUX2.28 (S20), P2.4
/OUTA5: MUX1.8 (S5), MUX2.29 (S21), P2.5
/OUTA6: MUX1.7 (S6), MUX2.30 (S22), P2.6
/OUTA7: MUX1.6 (S7), MUX2.31 (S23), P2.7
/OUTA8: MUX1.5 (S8), MUX2.32 (S24), P2.8
/OUTA9: MUX1.4 (S9), MUX2.33 (S25), P2.9
/OUTA10: MUX1.3 (S10), MUX2.34 (S26), P2.10
/OUTA11: MUX1.2 (S11), MUX2.35 (S27), P2.11
/OUTA12: MUX1.1 (S12), MUX2.36 (S28), P2.12
/OUTA13: MUX1.48 (S13), MUX2.37 (S29), P2.13
/OUTA14: MUX1.47 (S14), MUX2.38 (S30), P2.14
/OUTA15: MUX1.46 (S15), MUX2.39 (S31), P2.15
/OUTA16: MUX1.45 (S16), MUX2.40 (S32), P2.16
/OUTA17: MUX1.40 (S32), MUX2.45 (S16), P3.1
/OUTA18: MUX1.39 (S31), MUX2.46 (S15), P3.2
/OUTA19: MUX1.38 (S30), MUX2.47 (S14), P3.3
/OUTA20: MUX1.37 (S29), MUX2.48 (S13), P3.4
/OUTA21: MUX1.36 (S28), MUX2.1 (S12), P3.5
/OUTA22: MUX1.35 (S27), MUX2.2 (S11), P3.6
/OUTA23: MUX1.34 (S26), MUX2.3 (S10), P3.7
/OUTA24: MUX1.33 (S25), MUX2.4 (S9), P3.8
/OUTA25: MUX1.32 (S24), MUX2.5 (S8), P3.9
/OUTA26: MUX1.31 (S23), MUX2.6 (S7), P3.10
/OUTA27: MUX1.30 (S22), MUX2.7 (S6), P3.11
/OUTA28: MUX1.29 (S21), MUX2.8 (S5), P3.12
/OUTA29: MUX1.28 (S20), MUX2.9 (S4), P3.13
/OUTA30: MUX1.27 (S19), MUX2.10 (S3), P3.14
/OUTA31: MUX1.26 (S18), MUX2.11 (S2), P3.15
/OUTA32: MUX1.25 (S17), MUX2.12 (S1), P3.16
/OUTB1: MUX3.12 (S1), MUX4.25 (S17), P9.1
/OUTB2: MUX3.11 (S2), MUX4.26 (S18), P9.2
/OUTB3: MUX3.10 (S3), MUX4.27 (S19), P9.3
/OUTB4: MUX3.9 (S4), MUX4.28 (S20), P9.4
/OUTB5: MUX3.8 (S5), MUX4.29 (S21), P9.5
/OUTB6: MUX3.7 (S6), MUX4.30 (S22), P9.6
/OUTB7: MUX3.6 (S7), MUX4.31 (S23), P9.7
/OUTB8: MUX3.5 (S8), MUX4.32 (S24), P9.8
/OUTB9: MUX3.4 (S9), MUX4.33 (S25), P9.9
/OUTB10: MUX3.3 (S10), MUX4.34 (S26), P9.10
/OUTB11: MUX3.2 (S11), MUX4.35 (S27), P9.11
/OUTB12: MUX3.1 (S12), MUX4.36 (S28), P9.12
/OUTB13: MUX3.48 (S13), MUX4.37 (S29), P9.13
/OUTB14: MUX3.47 (S14), MUX4.38 (S30), P9.14
/OUTB15: MUX3.46 (S15), MUX4.39 (S31), P9.15
/OUTB16: MUX3.45 (S16), MUX4.40 (S32), P9.16
/OUTB17: MUX3.40 (S32), MUX4.45 (S16), P8.1
/OUTB18: MUX3.39 (S31), MUX4.46 (S15), P8.2
/OUTB19: MUX3.38 (S30), MUX4.47 (S14), P8.3
/OUTB20: MUX3.37 (S29), MUX4.48 (S13), P8.4
/OUTB21: MUX3.36 (S28), MUX4.1 (S12), P8.5
/OUTB22: MUX3.35 (S27), MUX4.2 (S11), P8.6
/OUTB23: MUX3.34 (S26), MUX4.3 (S10), P8.7
/OUTB24: MUX3.33 (S25), MUX4.4 (S9), P8.8
/OUTB25: MUX3.32 (S24), MUX4.5 (S8), P8.9
/OUTB26: MUX3.31 (S23), MUX4.6 (S7), P8.10
/OUTB27: MUX3.30 (S22), MUX4.7 (S6), P8.11
/OUTB28: MUX3.29 (S21), MUX4.8 (S5), P8.12
/OUTB29: MUX3.28 (S20), MUX4.9 (S4), P8.13
/OUTB30: MUX3.27 (S19), MUX4.10 (S3), P8.14
/OUTB31: MUX3.26 (S18), MUX4.11 (S2), P8.15
/OUTB32: MUX3.25 (S17), MUX4.12 (S1), P8.16
/WR: MUX1.21 (WR), MUX2.21 (WR), MUX3.21 (WR), MUX4.21 (WR), P4.3, P4.4
GND: C1.2, C2.2, C3.2, C4.2, C5.2, C6.1, C7.2, C8.2, C9.2, C10.1, MUX1.23 (GND), MUX2.23 (GND), MUX3.23 (GND), MUX4.23 (GND), P7.1, P7.2, P7.3, P7.4
VDD: C3.1, C4.1, C5.1, C9.1, C10.2, MUX1.13 (VDD), MUX1.14 (VDD), MUX2.13 (VDD), MUX2.14 (VDD), MUX3.13 (VDD), MUX3.14 (VDD), MUX4.13 (VDD), MUX4.14 (VDD), P11.3, P11.4
VSS: C1.1, C2.1, C6.2, C7.1, C8.1, MUX1.24 (VSS), MUX2.24 (VSS), MUX3.24 (VSS), MUX4.24 (VSS), P11.1, P11.2

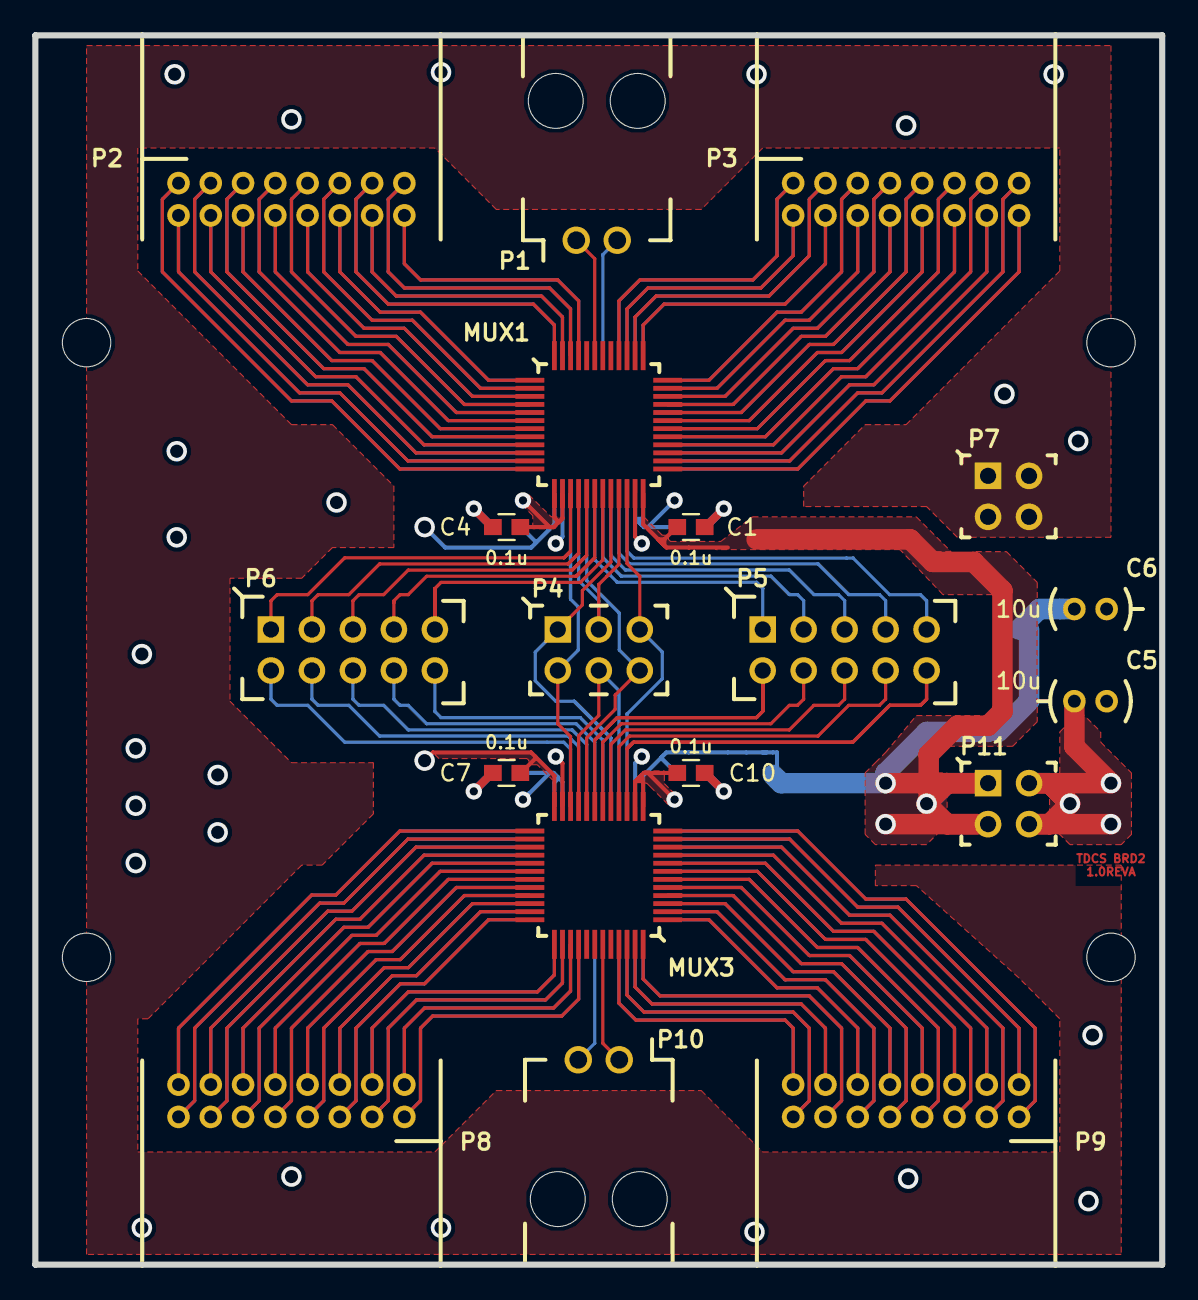
[picture p64: board demux-panel.kicad_pcb from above]

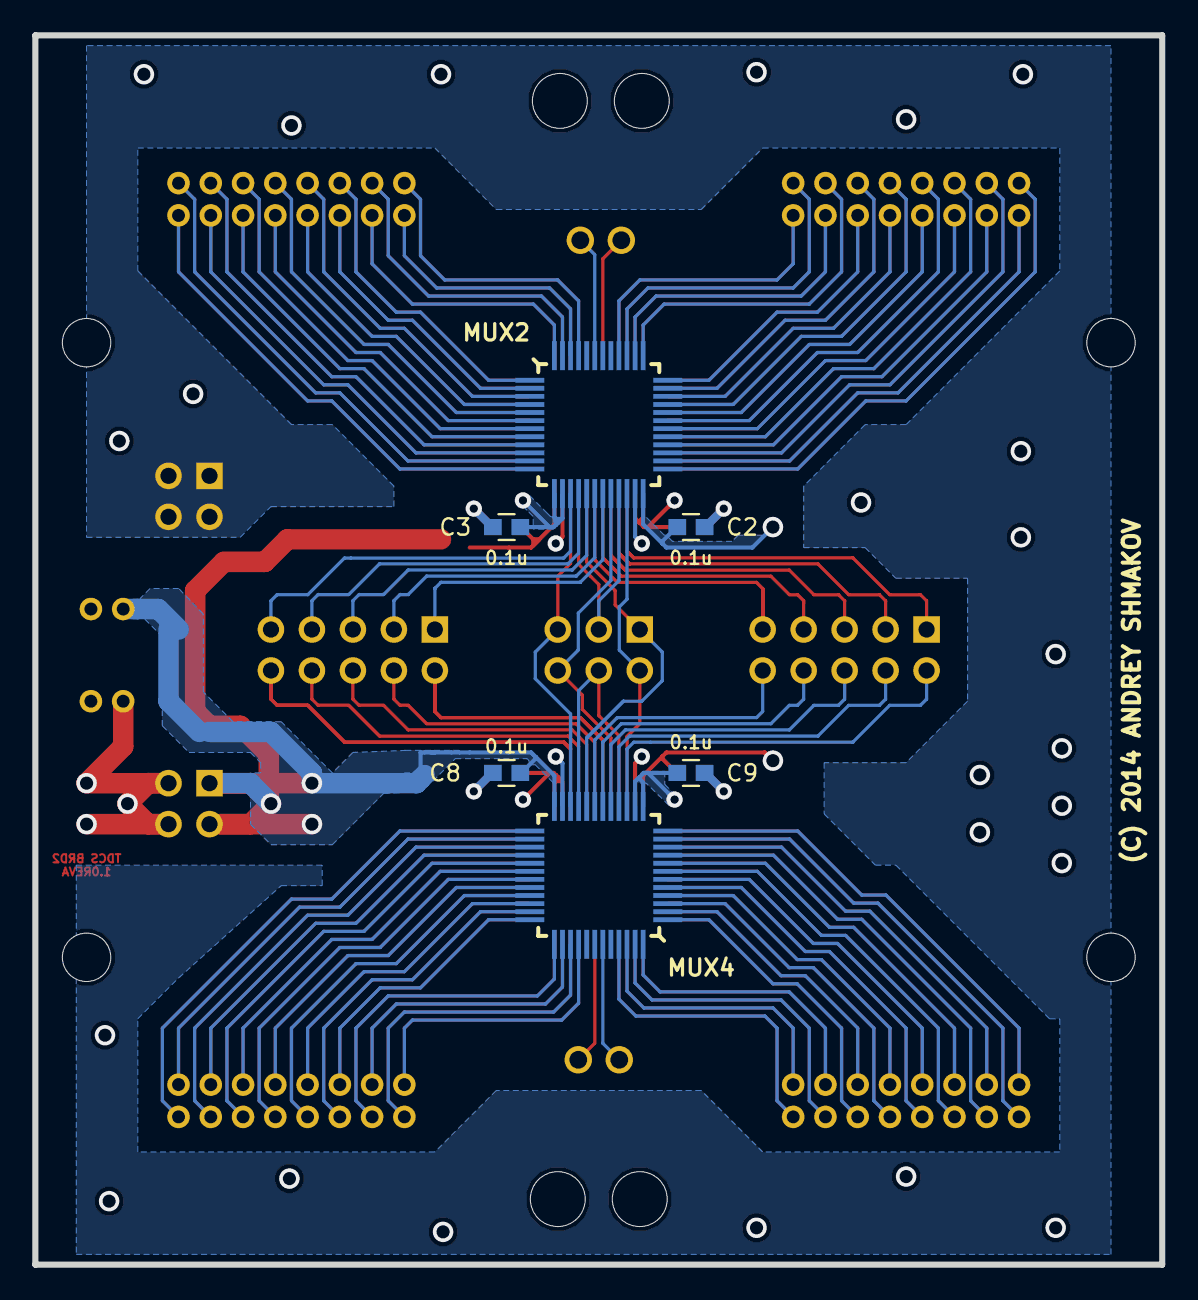
[picture p65: board demux-panel.kicad_pcb from below]

Board: 4 copper layers, 69.8 x 76.2 mm, 29 parts (6 on the bottom side), 84 nets.
