Fijee-Project/utCS/hw/demux_daughterboard/kicad_proj/figuresch/board_layout.kicad_pcb

## KiCad design hw/demux_daughterboard/kicad_proj/figuresch/board_layout.kicad_pcb (2014-04-01)

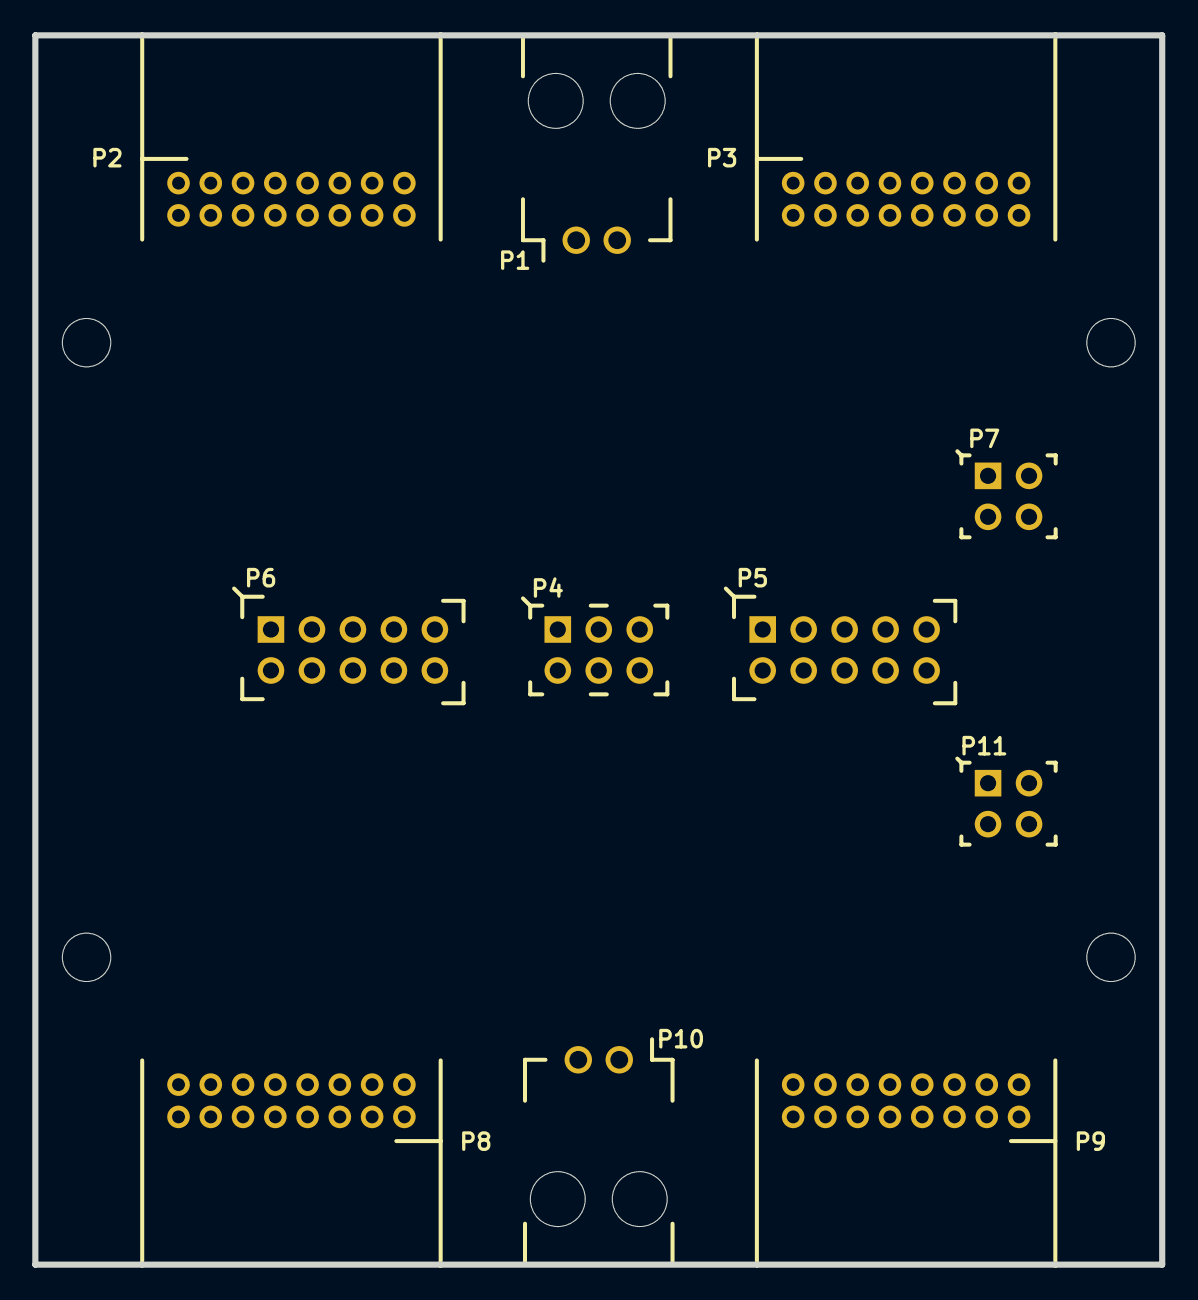
[picture p66: board board_layout.kicad_pcb from above]

Board: 4 copper layers, 69.8 x 76.2 mm, 15 parts (0 on the bottom side), 16 nets, no tracks yet.

Parts:
P1, P10: CONN_2; CONN_1X2_MOLEX_SL_TH
P2, P3, P8, P9: CONN_8X2; MOLEX_iGRID_2MM_16PIN
P4: CONN_3X2; HEADER-2x3-SAMTEC
P5, P6: CONN_5X2; HEADER-2x5-SAMTEC
P7, P11: CONN_2X2; HEADER-2x2-SAMTEC
SCREW1, SCREW2, SCREW3, SCREW4: CONN_1; SCREW_3mm

Connections:
/A0: P5.10, P6.1
/A1: P5.8, P6.3
/A2: P5.6, P6.5
/A3: P5.4, P6.7
/A4: P5.2, P6.9
/B0: P5.9, P6.2
/B1: P5.7, P6.4
/B2: P5.5, P6.6
/B3: P5.3, P6.8
/B4: P5.1, P6.10
/CS: P4.1, P4.6
/EN: P4.2, P4.5
/WR: P4.3, P4.4
GND: P7.1, P7.2, P7.3, P7.4
VDD: P11.3, P11.4
VSS: P11.1, P11.2
