Fijee-Project/utCS/hw/main_board/kicad_project/.kicad_pcb.kicad_pcb

## KiCad design hw/main_board/kicad_project/.kicad_pcb.kicad_pcb (2014-03-16)

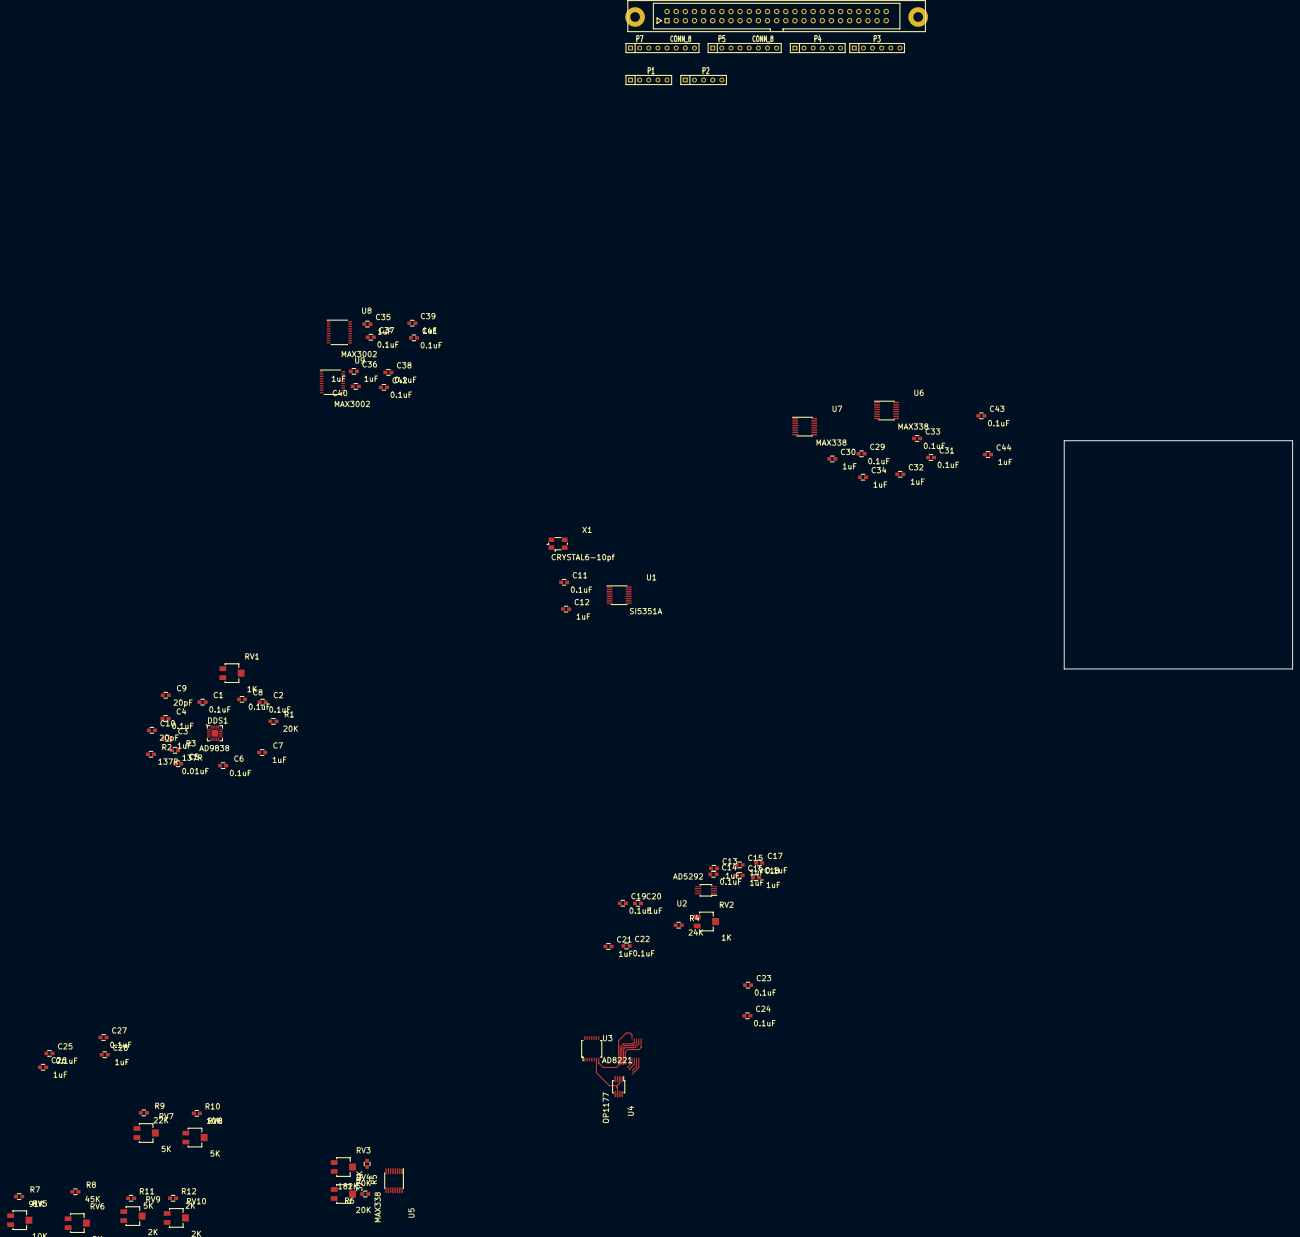
[picture p67: board .kicad_pcb.kicad_pcb from above]

Board: 4 copper layers, 63.5 x 63.5 mm, 84 parts (0 on the bottom side), 107 nets.

Parts:
C1, C2, C4, C6, C8, C11, C14, C17, C19, C22, C23, C24, C25, C27, C29, C31, C33, C37, C38, C41, C42, C43: 0.1uF; 0603
C3, C7, C12, C15, C16, C18, C20, C21, C26, C28, C30, C32, C34, C35, C36, C39, C40, C44: 1uF; 0603
C5: 0.01uF; 0603
C9, C10: 20pF; 0603
C13: .1uF; 0603
DDS1: AD9838; LFCSP20_WQ
P1, P2: CONN_5; SIL-5
P3: CONN_6; SIL-6
P4: CONN_3X2; SIL-6
P5, P7: CONN_8; SIL-8
P6: CONN_20X2; HE10_50D
R1: 20K; 0603
R2, R3: 137R; 0603
R4: 24K; 0603
R5: 374K; 0603
R6: 182K; 0603
R7: 91K; 0603
R8: 45K; 0603
R9: 22K; 0603
R10: 10K; 0603
R11: 5K; 0603
R12: 2K; 0603
RV1, RV2: 1K; 3224X
RV3, RV4: 20K; 3224X
RV5: 10K; 3224X
RV6, RV7, RV8: 5K; 3224X
RV9, RV10: 2K; 3224X
U1: SI5351A; QSOP_16
U2: AD5292; MSOP-10
U3: AD8221; TSSOP_14
U4: OP1177; MSOP_8
U5, U6, U7: MAX338; QSOP_16
U8, U9: MAX3002; TSSOP_20
X1: CRYSTAL6-10pf; ECX_53B

Connections:
/Clock/CLK_TWI0: P6.8, U1.4
/Clock/CLK_TWI1: P6.10, U1.5
/CurrentSource/AD8211_IOUT: U3.7, U5.8
/CurrentSource/DPOT_A: R4.2, U2.3
/CurrentSource/DPOT_W: RV2.1, RV2.2, U2.4, U2.5
/CurrentSource/GAIN_BUS0: P6.34, U2.1
/CurrentSource/GAIN_BUS1: P6.36, U2.10
/CurrentSource/IOUT: RV3.3, RV4.3, RV5.3, RV6.3, RV7.3, RV8.3, RV9.3, RV10.3, U4.3, U6.8
/CurrentSource/RANGE1: R12.1, U5.4
/CurrentSource/RANGE2: R11.1, U5.5
/CurrentSource/RANGE3: R10.1, U5.6
/CurrentSource/RANGE4: R9.1, U5.7
/CurrentSource/RANGE5: R8.1, U5.9
/CurrentSource/RANGE6: R7.1, U5.10
/CurrentSource/RANGE7: R6.1, U5.11
/CurrentSource/RANGE8: R5.1, U5.12
/CurrentSource/RG2: R4.1, U3.3
/CurrentSource/RNG_0: P6.26, U5.15
/CurrentSource/RNG_1: P6.28, U5.16
/CurrentSource/RNG_2: P6.30, U5.1
/CurrentSource/RNG_3: P6.32, U5.2
/CurrentSource/Rg1: RV2.3, U3.2
/CurrentSource/instr_ref: U3.6, U4.2, U4.6
/DDS/CLK_IN: DDS1.5, U1.10
/DDS/DDS_BUS0: DDS1.10, P6.12
/DDS/DDS_BUS1: DDS1.11, P6.14
/DDS/DDS_BUS2: DDS1.12, P6.16
/DDS/DDS_BUS3: DDS1.6, P6.18
/DDS/DDS_BUS4: DDS1.7, P6.20
/DDS/DDS_BUS5: DDS1.8, P6.22
/DDS/DDS_BUS6: DDS1.9, P6.24
/DDS/VOut: C9.1, DDS1.16, R2.2, U3.4
/DDS/VOut-: C10.1, DDS1.17, R3.2, U3.1
/LogicTranslators/IN_MUX0: P6.31, U6.2
/LogicTranslators/IN_MUX1: P6.33, U6.1
/LogicTranslators/IN_MUX2: P6.35, U6.16
/LogicTranslators/IN_MUX3: P6.37, U6.15
/LogicTranslators/OUT_MUX0: P6.39, U7.2
/LogicTranslators/OUT_MUX1: P6.2, U7.1
/LogicTranslators/OUT_MUX2: P6.4, U7.16
/LogicTranslators/OUT_MUX3: P6.6, U7.15
/LogicTranslators/UCOUT0: P6.1, U8.1
/LogicTranslators/UCOUT1: P6.3, U8.3
/LogicTranslators/UCOUT2: P6.5, U8.4
/LogicTranslators/UCOUT3: P6.7, U8.5
/LogicTranslators/UCOUT4: P6.9, U8.6
/LogicTranslators/UCOUT5: P6.11, U8.7
/LogicTranslators/UCOUT6: P6.13, U8.8
/LogicTranslators/UCOUT7: P6.15, U8.9
/LogicTranslators/UCOUT8: P6.17, U8.10
/LogicTranslators/UCOUT9: P6.19, U9.10
/LogicTranslators/UCOUT10: P6.21, U9.9
/LogicTranslators/UCOUT11: P6.23, U9.8
/LogicTranslators/UCOUT12: P6.25, U9.7
/LogicTranslators/UCOUT13: P6.27, U9.6
/LogicTranslators/UCOUT14: P6.29, U9.5
/MUXC0: P1.1, U8.20
/MUXC1: P1.2, U8.18
/MUXC2: P1.3, U8.17
/MUXC3: P1.4, U8.16
/MUXC4: P1.5, U8.15
/MUXCOM0: P3.5, U8.12
/MUXCOM1: P3.3, U8.13
/MUXCOM2: P3.2, U8.14
/MUXD0: P2.1, U9.12
/MUXD1: P2.2, U9.13
/MUXD2: P2.3, U9.14
/MUXD3: P2.4, U9.15
/MUXD4: P2.5, U9.16
/OutputMultiplexer/MUXA0: P7.1, U6.12
/OutputMultiplexer/MUXA1: P7.2, U7.12
/OutputMultiplexer/MUXA2: P7.3, U6.11
/OutputMultiplexer/MUXA3: P7.4, U7.11
/OutputMultiplexer/MUXA4: P7.5, U6.10
/OutputMultiplexer/MUXA5: P7.6, U7.10
/OutputMultiplexer/MUXA6: P7.7, U6.9
/OutputMultiplexer/MUXA7: P7.8, U7.9
/OutputMultiplexer/MUXB0: P5.1, U6.4
/OutputMultiplexer/MUXB1: P5.2, U7.4
/OutputMultiplexer/MUXB2: P5.3, U6.5
/OutputMultiplexer/MUXB3: P5.4, U7.5
/OutputMultiplexer/MUXB4: P5.5, U6.6
/OutputMultiplexer/MUXB5: P5.6, U7.6
/OutputMultiplexer/MUXB6: P5.7, U6.7
/OutputMultiplexer/MUXB7: P5.8, U7.7
/powergen/MUXVSS: P3.6, P4.2
AGND: C1.2, C2.2, C3.1, C4.1, C6.1, C7.1, C8.1, C9.2, C10.2, C11.2, C12.2, C13.2, C14.2, C15.2, C16.2, C17.2, C18.2, C19.2, C20.2, C21.2, C22.2, C23.2, C24.2, C25.2, C26.2, C27.2, C28.2, C29.2, C30.2, C31.2, C32.2, C33.2, C34.2, C35.2, C36.2, C37.2, C38.2, C39.2, C40.2, C41.2, C42.2, C43.2, C44.2, DDS1.4, DDS1.15, P3.4, P4.4, R2.1, R3.1, RV1.3, U2.9, U5.14, U6.14, U7.8, U7.14, U8.11, U9.11
AVDD: C17.1, C18.1, C19.1, C20.1, C23.1, C25.1, C26.1, C29.1, C30.1, C33.1, C34.1, P4.5, U2.6, U3.8, U4.7, U5.3, U6.13, U7.13
AVDD_3V3: C1.1, C3.2, C5.2, C6.2, C7.2, C11.1, C12.1, C16.1, C39.1, C40.1, C41.1, C42.1, DDS1.1, DDS1.2, P4.3, U1.1, U1.7, U2.8, U8.2, U9.2
AVSS: C14.1, C15.1, C21.1, C22.1, C24.1, C27.1, C28.1, C31.1, C32.1, C43.1, C44.1, P4.6, U2.2, U3.5, U4.4, U5.13, U6.3, U7.3
DVDD_2V5: C35.1, C36.1, C37.1, C38.1, P3.1, P4.1, U8.19, U9.19
unnamed: C2.1, DDS1.19
unnamed: C4.2, DDS1.3
unnamed: C5.1, DDS1.20
unnamed: C8.2, DDS1.18, R1.1
unnamed: R1.2, RV1.1, RV1.2
unnamed: R9.2, RV7.1, RV7.2
unnamed: R5.2, RV3.1, RV3.2
unnamed: R6.2, RV4.1, RV4.2
unnamed: R8.2, RV6.1, RV6.2
unnamed: R7.2, RV5.1, RV5.2
unnamed: R10.2, RV8.1, RV8.2
unnamed: R11.2, RV9.1, RV9.2
unnamed: R12.2, RV10.1, RV10.2
unnamed: C13.1, U2.7
unnamed: U1.3, X1.2
unnamed: U1.2, X1.1
