Fijee-Project/utCS/hw/demux_daughterboard/kicad_proj/demux-panel.sch

## KiCad design hw/demux_daughterboard/kicad_proj/demux-panel.sch (2014-03-17, an earlier design)

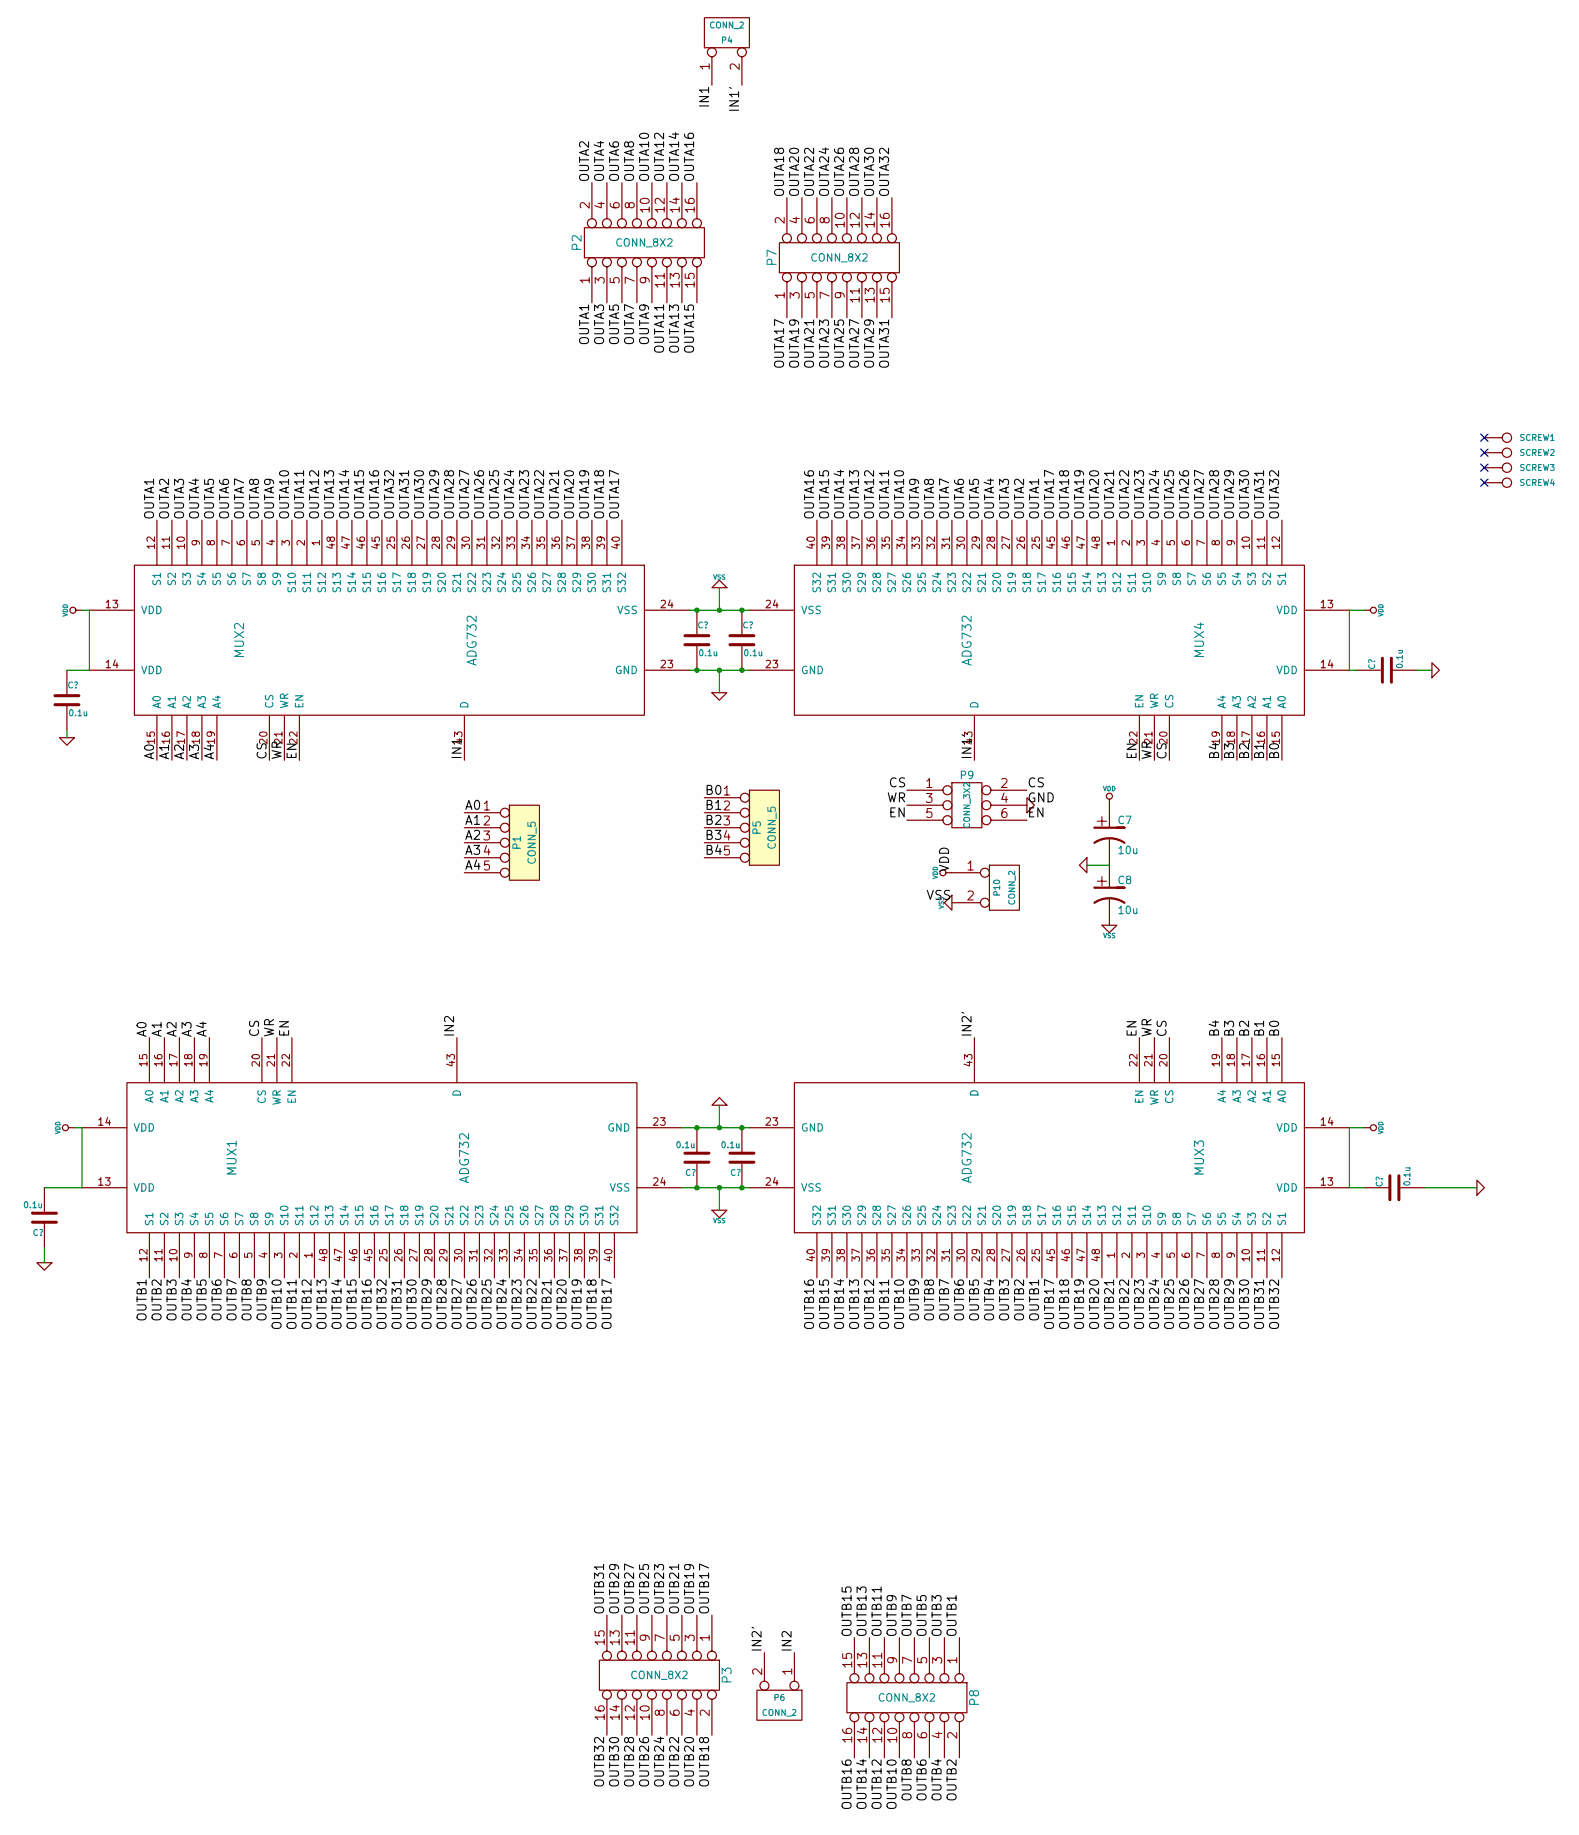
[picture p68: schematic demux-panel.sch]

Parts:
C7, C8: 10u
MUX1, MUX2, MUX3, MUX4: ADG732
P1, P5: CONN_5
P2, P3, P7, P8: CONN_8X2
P4, P6, P10: CONN_2
P9: CONN_3X2
SCREW1, SCREW2, SCREW3, SCREW4: CONN_1

Connections:
A0: MUX1.15 (A0), MUX2.15 (A0), P1.1
A1: MUX1.16 (A1), MUX2.16 (A1), P1.2
A2: MUX1.17 (A2), MUX2.17 (A2), P1.3
A3: MUX1.18 (A3), MUX2.18 (A3), P1.4
A4: MUX1.19 (A4), MUX2.19 (A4), P1.5
B0: MUX3.15 (A0), MUX4.15 (A0), P5.1
B1: MUX3.16 (A1), MUX4.16 (A1), P5.2
B2: MUX3.17 (A2), MUX4.17 (A2), P5.3
B3: MUX3.18 (A3), MUX4.18 (A3), P5.4
B4: MUX3.19 (A4), MUX4.19 (A4), P5.5
CS: MUX1.20 (CS), MUX2.20 (CS), MUX3.20 (CS), MUX4.20 (CS), P9.1, P9.2
EN: MUX1.22 (EN), MUX2.22 (EN), MUX3.22 (EN), MUX4.22 (EN), P9.5, P9.6
GND: C7.2, C8.1, MUX1.23 (GND), MUX2.23 (GND), MUX3.23 (GND), MUX4.23 (GND), P9.4
IN1: MUX2.43 (D), P4.1
IN1': MUX4.43 (D), P4.2 (PM)
IN2: MUX1.43 (D), P6.1
IN2': MUX3.43 (D), P6.2 (PM)
OUTA1: MUX2.12 (S1), MUX4.25 (S17), P2.1
OUTA2: MUX2.11 (S2), MUX4.26 (S18), P2.2
OUTA3: MUX2.10 (S3), MUX4.27 (S19), P2.3
OUTA4: MUX2.9 (S4), MUX4.28 (S20), P2.4
OUTA5: MUX2.8 (S5), MUX4.29 (S21), P2.5
OUTA6: MUX2.7 (S6), MUX4.30 (S22), P2.6
OUTA7: MUX2.6 (S7), MUX4.31 (S23), P2.7
OUTA8: MUX2.5 (S8), MUX4.32 (S24), P2.8
OUTA9: MUX2.4 (S9), MUX4.33 (S25), P2.9
OUTA10: MUX2.3 (S10), MUX4.34 (S26), P2.10
OUTA11: MUX2.2 (S11), MUX4.35 (S27), P2.11
OUTA12: MUX2.1 (S12), MUX4.36 (S28), P2.12
OUTA13: MUX2.48 (S13), MUX4.37 (S29), P2.13
OUTA14: MUX2.47 (S14), MUX4.38 (S30), P2.14
OUTA15: MUX2.46 (S15), MUX4.39 (S31), P2.15
OUTA16: MUX2.45 (S16), MUX4.40 (S32), P2.16
OUTA17: MUX2.40 (S32), MUX4.45 (S16), P7.1
OUTA18: MUX2.39 (S31), MUX4.46 (S15), P7.2
OUTA19: MUX2.38 (S30), MUX4.47 (S14), P7.3
OUTA20: MUX2.37 (S29), MUX4.48 (S13), P7.4
OUTA21: MUX2.36 (S28), MUX4.1 (S12), P7.5
OUTA22: MUX2.35 (S27), MUX4.2 (S11), P7.6
OUTA23: MUX2.34 (S26), MUX4.3 (S10), P7.7
OUTA24: MUX2.33 (S25), MUX4.4 (S9), P7.8
OUTA25: MUX2.32 (S24), MUX4.5 (S8), P7.9
OUTA26: MUX2.31 (S23), MUX4.6 (S7), P7.10
OUTA27: MUX2.30 (S22), MUX4.7 (S6), P7.11
OUTA28: MUX2.29 (S21), MUX4.8 (S5), P7.12
OUTA29: MUX2.28 (S20), MUX4.9 (S4), P7.13
OUTA30: MUX2.27 (S19), MUX4.10 (S3), P7.14
OUTA31: MUX2.26 (S18), MUX4.11 (S2), P7.15
OUTA32: MUX2.25 (S17), MUX4.12 (S1), P7.16
OUTB1: MUX1.12 (S1), MUX3.25 (S17), P8.1
OUTB2: MUX1.11 (S2), MUX3.26 (S18), P8.2
OUTB3: MUX1.10 (S3), MUX3.27 (S19), P8.3
OUTB4: MUX1.9 (S4), MUX3.28 (S20), P8.4
OUTB5: MUX1.8 (S5), MUX3.29 (S21), P8.5
OUTB6: MUX1.7 (S6), MUX3.30 (S22), P8.6
OUTB7: MUX1.6 (S7), MUX3.31 (S23), P8.7
OUTB8: MUX1.5 (S8), MUX3.32 (S24), P8.8
OUTB9: MUX1.4 (S9), MUX3.33 (S25), P8.9
OUTB10: MUX1.3 (S10), MUX3.34 (S26), P8.10
OUTB11: MUX1.2 (S11), MUX3.35 (S27), P8.11
OUTB12: MUX1.1 (S12), MUX3.36 (S28), P8.12
OUTB13: MUX1.48 (S13), MUX3.37 (S29), P8.13
OUTB14: MUX1.47 (S14), MUX3.38 (S30), P8.14
OUTB15: MUX1.46 (S15), MUX3.39 (S31), P8.15
OUTB16: MUX1.45 (S16), MUX3.40 (S32), P8.16
OUTB17: MUX1.40 (S32), MUX3.45 (S16), P3.1
OUTB18: MUX1.39 (S31), MUX3.46 (S15), P3.2
OUTB19: MUX1.38 (S30), MUX3.47 (S14), P3.3
OUTB20: MUX1.37 (S29), MUX3.48 (S13), P3.4
OUTB21: MUX1.36 (S28), MUX3.1 (S12), P3.5
OUTB22: MUX1.35 (S27), MUX3.2 (S11), P3.6
OUTB23: MUX1.34 (S26), MUX3.3 (S10), P3.7
OUTB24: MUX1.33 (S25), MUX3.4 (S9), P3.8
OUTB25: MUX1.32 (S24), MUX3.5 (S8), P3.9
OUTB26: MUX1.31 (S23), MUX3.6 (S7), P3.10
OUTB27: MUX1.30 (S22), MUX3.7 (S6), P3.11
OUTB28: MUX1.29 (S21), MUX3.8 (S5), P3.12
OUTB29: MUX1.28 (S20), MUX3.9 (S4), P3.13
OUTB30: MUX1.27 (S19), MUX3.10 (S3), P3.14
OUTB31: MUX1.26 (S18), MUX3.11 (S2), P3.15
OUTB32: MUX1.25 (S17), MUX3.12 (S1), P3.16
VDD: C7.1, MUX1.13 (VDD), MUX1.14 (VDD), MUX2.13 (VDD), MUX2.14 (VDD), MUX3.13 (VDD), MUX3.14 (VDD), MUX4.13 (VDD), MUX4.14 (VDD), P10.1
VSS: C8.2, MUX1.24 (VSS), MUX2.24 (VSS), MUX3.24 (VSS), MUX4.24 (VSS), P10.2 (PM)
WR: MUX1.21 (WR), MUX2.21 (WR), MUX3.21 (WR), MUX4.21 (WR), P9.3
