Fijee-Project/utCS/(commit log)

2014-02-01 added initial board files
    [DDS.sch, demux-panel-redux.brd, demux-panel.brd, demux-panel.sch, isourcesch.sch, logic.sch, logic2.sch, logic_.sch]
2014-02-01 folder restructuring
    [DDS.sch, demux-panel-redux.brd, demux-panel.brd, demux-panel.sch, isourcesch.sch, logic.sch, logic2.sch, logic_.sch]
2014-02-27 PWR_board hierarchy added
    [logic_conn.sch, power.sch, tDCS_driver.kicad_pcb, tDCS_driver.sch]
2014-02-28 keepnote notebook included to keep track of all design calculations
2014-02-28 custom kicad library for main board, fleshing out notes
    [logic_conn.sch, power.sch, tDCS_driver.sch]
2014-03-01 Main board module library, added SOIC-8, MSOP-8, MSOP-10, SOIC-10, other landing patterns, almost done
2014-03-01 finalized all footprints for main board, need to pick connectors and finalize stacking desing
    [$tDCS_driver.sch]
2014-03-01 working on gain control, added some schematics for document figure use only
    [DDS_stage.sch, range_calc_spreadsheet.ods]
2014-03-04 refactored schematic, finalized gain/range
    [$noname.sch, DDS.sch, clk.sch, currentstage.sch, isourcesch.sch, logic_conn.sch, mux.sch, power.sch]
2014-03-05 starting power supply design, still collecting notes
    [DDS.sch, power.sch, range_calc_spreadsheet.ods]
2014-03-07 started mainboard pcb layout, fixing small things in schematic, TODO: schematic connector symbols and pads
    [DDS.sch, DDS_stage.sch, clk.sch, isourcesch.sch, logic_conn.sch, mux.sch, power.sch, tDCS_driver.sch]
2014-03-10 Cleaned up main board component library
2014-03-11 started mainboard pcb assembly
2014-03-12 connectors for main_pcb still deciding on proper footprint/layout
2014-03-16 final rework of mux board, finalizing stacking connectors, almost there
    [$demux-panel.sch, .kicad_pcb.kicad_pcb, DDS.sch, IPC-7251 Padstack Charts.xls, clk.sch, demux-panel-old.brd, demux-panel.kicad_pcb, demux-panel.sch]
2014-03-17 Finished daughterboard pcb with fusion pcb constraints, TODO: silkscreen
    [$demux-panel.sch, $noname.sch, $tDCS_driver.sch, demux-panel-redux.brd, demux-panel.brd, demux-panel.kicad_pcb, demux-panel.sch]
2014-03-18 daughterboard silkscreen finalized, gerbers generated for 1.0RevA
    [demux.gbl, demux.gbo, demux.gbs, demux.gko, demux.gtl, demux.gto, demux.gts]
2014-03-20 finished component layout on mainboard, need to route power planes and the digital control signal lines
    [$noname.sch, DDS.sch, clk.sch, isourcesch.sch, logic_conn.sch, mux.sch, power.sch, tDCS_driver.kicad_pcb]
2014-03-29 finished board and gerber outputed, time for documentation
    [tDCS_driver.gbl, tDCS_driver.gbo, tDCS_driver.gbs, tDCS_driver.gtl, tDCS_driver.gto, tDCS_driver.gts]
2014-04-01 Converting keepnote notes to thorough design documentation, starting with BRD1
    [DDS.sch, DDS_stage.sch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]
2014-04-02 forgot to add files in last commit
    [$noname.sch, clocksch.sch, currentstage.sch, noname.sch, range_select.sch]
2014-06-06 local changes to notes and most production gerber file
    [$demux-panel.sch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]
