Fijee-Project/utCS/(notices)

Notices in the files:
hw/demux_daughterboard/kicad_proj/figuresch/board_layout.kicad_pcb:
Copyright Andrey Shmakov 2014
hw/demux_daughterboard/kicad_proj/demux-panel.kicad_pcb:
(C) 2014 ANDREY SHMAKOV
